NUCEOTIDE/NUCLEOTIDE.github.io/our design.jpg

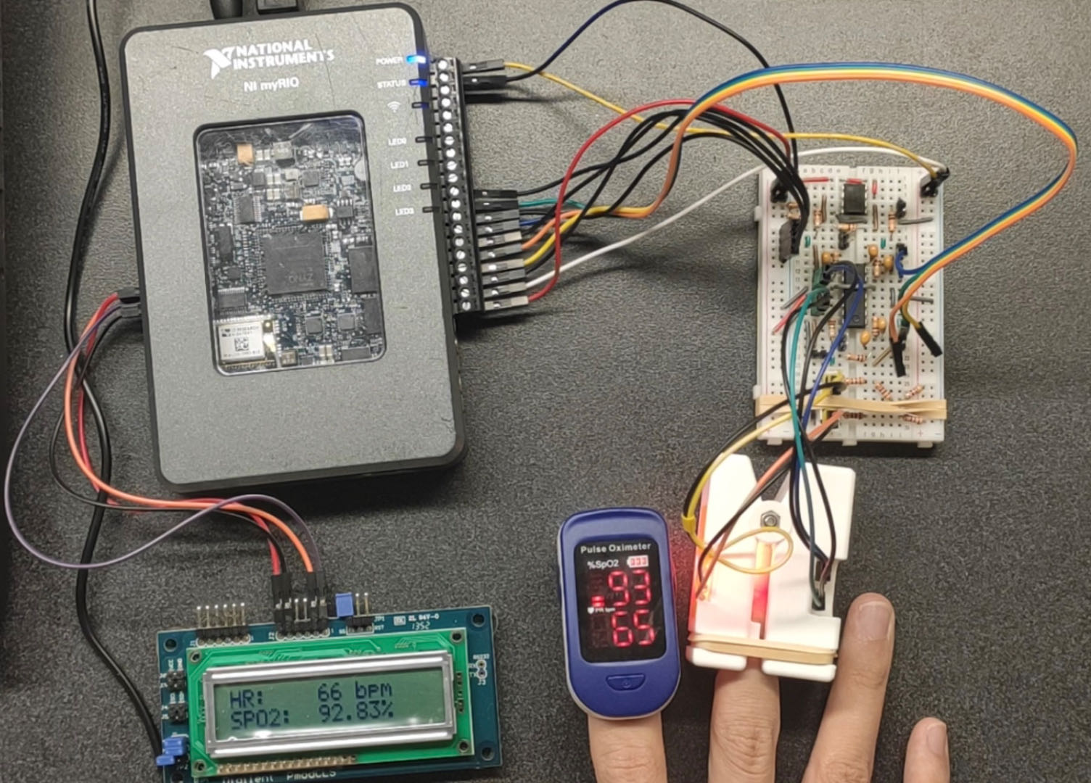
our design.jpg
