NUCEOTIDE/NUCLEOTIDE.github.io/Experimental Data/finger_5_11_25.jpg

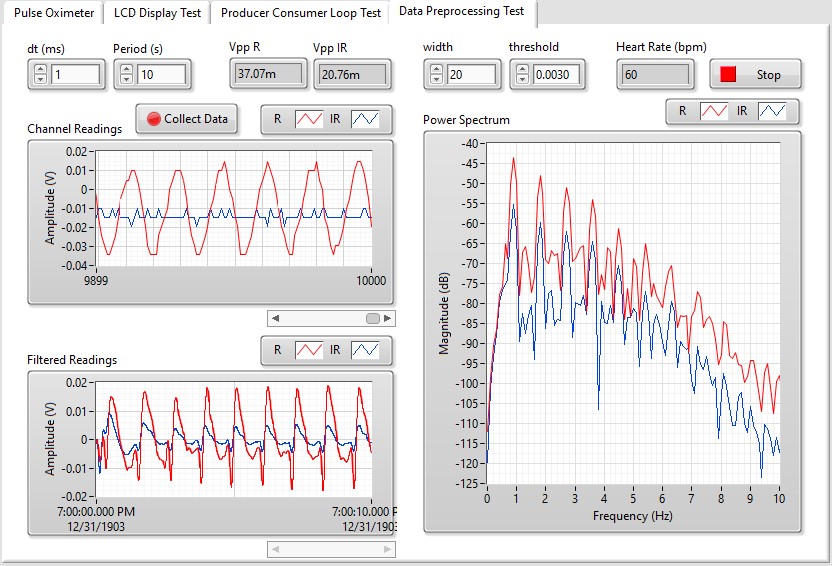
Experimental Data/finger_5_11_25.jpg
