NUCEOTIDE/NUCLEOTIDE.github.io/README.md

# NUCLEOTIDE.github.io
 Github page for ME 6705 FQ2023 Team 8 Pulse Oximeter Demo
