NUCEOTIDE/NUCLEOTIDE.github.io/Design Notes/Final Project SMD v4.pdf

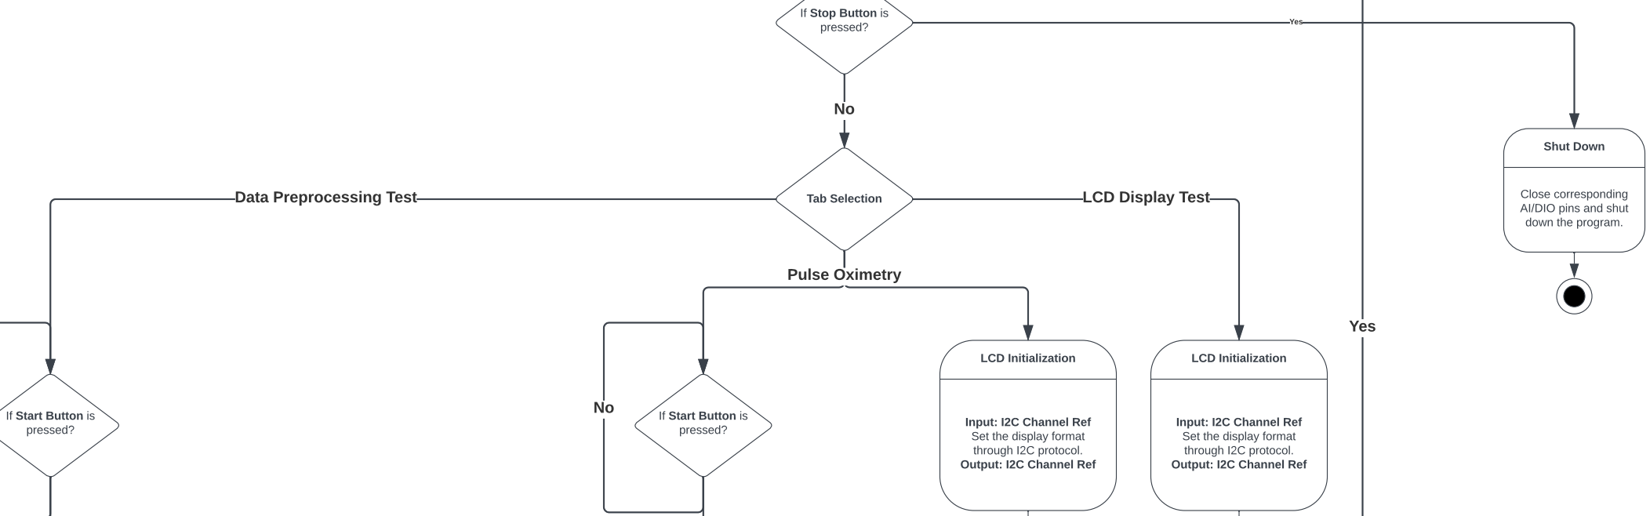
[picture p13: figure]
Shut Down; Close corresponding AI/DIO pins and shut down the program.; Yes; Data Preprocessing Test; Tab Selection; LCD Initialization; Input: I2C Channel Ref Set the display format; If Stop Button is pressed?; LCD Display Test; If Start Button is pressed?; Pulse Oximetry

Retrieve Voltage Readings

Input: AI DIO I2C Channel Ref, Record Params (Interval, Period) Retrieve the amplified/filtered voltage

readings from the R/IR photodiodes and store them in arrays. Output: R and IR channel Voltage Readings

If Time >= Period?

No

Yes

Calculate Blood-oxygen
Saturation and Heartrate

Input: Peak Detection Params (Width, %Threshold), SpO2
Params (R offset, IR offset) From the recorded oscillatory light intensity readings, find the average maximum and minimum intensity. Obtain the blood-oxygen saturation

according to derived formulas. Conduct a frequency analysis and

obtain the heartrate. Output: Light Intensity or

Illuminance (Imax R, Imin R, Imax IR, Imin IR), FFT (Max Freq R, Max Freq IR), SpO2, Heart Rate

Yes

LCD Refresh

Input: I2C Channel Ref, SpO2, Heart Rate Display the calculated

blood-oxygen saturation and heartrate on the LCD screen Output: Displayed Value

Interval ms

LabVIEW Display

Input: Light Intensity or
Illuminance (Imax R, Imin R, Imax IR, Imin IR), FFT (Max Freq R, Max Freq IR), SpO2, Heart Rate Display the obtained values and waveforms in corresponding

display zones.

Initialization

Initialize 2 AI Channels for R and IR photodiodes, 1 DI Channel for button, 2 I2C Channels for LCD Module Output: AI DIO I2C Channel Ref

through I2C protocol. Output: I2C Channel Ref

through I2C protocol. Output: I2C Channel Ref

## Yes

LCD Refresh

Input: I2C Channel Ref, SpO2, Heart Rate Display the calculated

blood-oxygen saturation and heartrate on the LCD screen Output: Displayed Value

If Stop Refreshing Button is

pressed?

No

Retrieve Voltage Readings

Input: AI DIO I2C Channel Ref, Record Params (Interval, Period) Retrieve the amplified/filtered voltage

readings from the R/IR photodiodes and store them in arrays. Output: R and IR channel Voltage Readings

If Time >= Period?

Yes

Yes

## Yes

No

LabVIEW Display

Input: Raw 2 Channel
Photodiode Waveform Signals Display the obtained values and waveforms in corresponding

display zones.

No

Calculate Blood-oxygen
Saturation and Heartrate

Input: Peak Detection Params (Width, %Threshold), SpO2
Params (R offset, IR offset) From the recorded oscillatory light intensity readings, find the average maximum and minimum intensity. Obtain the blood-oxygen saturation

according to derived formulas. Conduct a frequency analysis and

obtain the heartrate. Output: Light Intensity or

Illuminance (Imax R, Imin R, Imax IR, Imin IR), FFT (Max Freq R, Max Freq IR), SpO2, Heart Rate

LabVIEW Display

Input: Light Intensity or
Illuminance (Imax R, Imin R, Imax IR, Imin IR), FFT (Max Freq R, Max Freq IR), SpO2, Heart Rate Display the obtained values and waveforms in corresponding

display zones.

Interval ms
