NUCEOTIDE/NUCLEOTIDE.github.io/3D Design and Modeling/Finger Clip Design 1.png

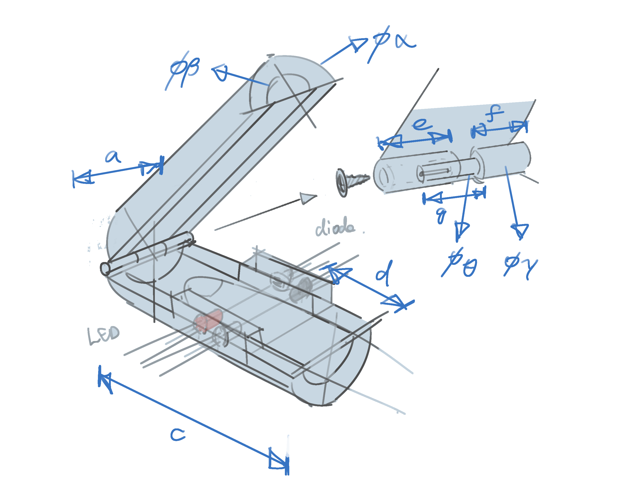
3D Design and Modeling/Finger Clip Design 1.png
