NUCEOTIDE/NUCLEOTIDE.github.io/Circuit Design and Characterization/Lab 7 Conditioning Circuit-schematic.png

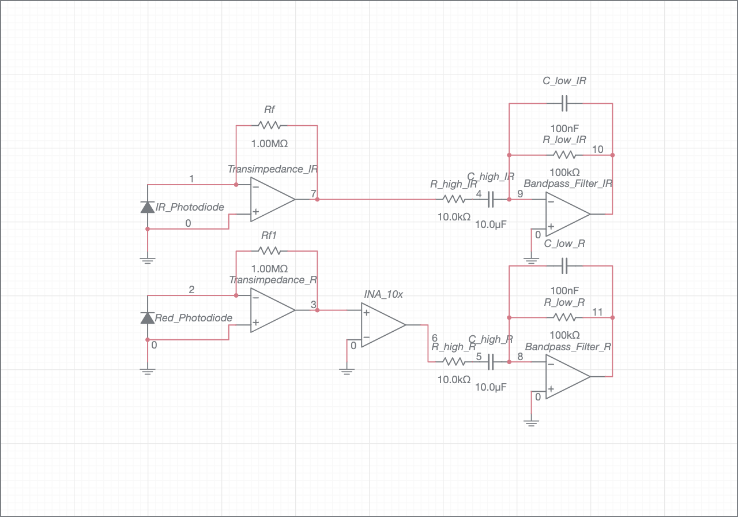
Circuit Design and Characterization/Lab 7 Conditioning Circuit-schematic.png
