NUCEOTIDE/NUCLEOTIDE.github.io/Circuit Design and Characterization/LED schematics v1.jpg

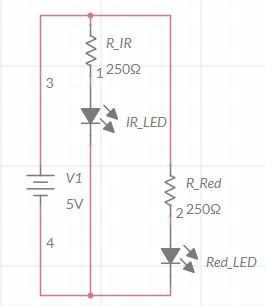
Circuit Design and Characterization/LED schematics v1.jpg
