NUCEOTIDE/NUCLEOTIDE.github.io/Design Notes/Front Panel/Pulse Oximeter Tab.jpg

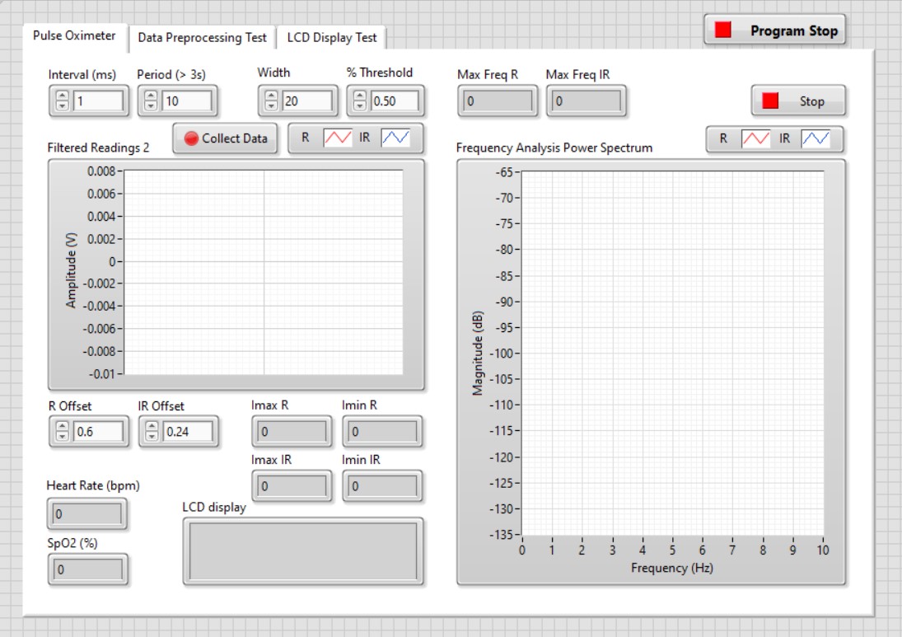
Design Notes/Front Panel/Pulse Oximeter Tab.jpg
