NUCEOTIDE/NUCLEOTIDE.github.io/Design Notes/Sub VIs/Data Acqu.jpg

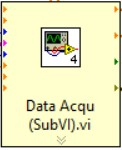
Design Notes/Sub VIs/Data Acqu.jpg
