NUCEOTIDE/NUCLEOTIDE.github.io/Design Notes/Sub VIs/Frequency Analysis.jpg

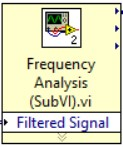
Design Notes/Sub VIs/Frequency Analysis.jpg
