NUCEOTIDE/NUCLEOTIDE.github.io/Design Notes/Sub VIs/Heart Rate.jpg

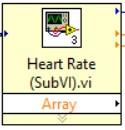
Design Notes/Sub VIs/Heart Rate.jpg
