NUCEOTIDE/NUCLEOTIDE.github.io/Design Notes/Sub VIs/Illuminance.jpg

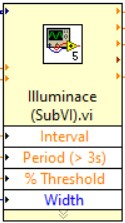
Design Notes/Sub VIs/Illuminance.jpg
