NUCEOTIDE/NUCLEOTIDE.github.io/Design Notes/Sub VIs/SpO2.jpg

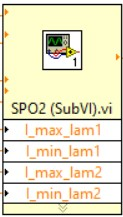
Design Notes/Sub VIs/SpO2.jpg
