NUCEOTIDE/NUCLEOTIDE.github.io/Team8_Canvas_Submission_Final_Project/Engineering and User Specifications Team8_Yifei_Tianyang_v21.xlsx

Sheet: Draft
ME/AE 6705 Final Project Technical Requirements - Template
Detailing engineering and user specifications
Project Title: |  | Digital Pulse Oximiter
Team Number: |  | 8
Team Names: |  | Tianyang Hu, Yifei Du
Category | No. | Threshold/Objective* | Requirement | Value | Unit | Comment
Interface |  | T | Users shall interface with the prototype via a Labview Control Panel | T/F
 |  | O | System will provide debug logs to the Labview Control Panel | T/F
Data Capturing |  | T | System will sample new photodiode data at least every 3 ms (interval < 60Hz power line). | 3 | ms | (sampling with a higher frequency allows higher-quality signal conditioning)
 |  | O | System will sample photodiode data continuously to obtain an moving average heart rate and blood oxygen saturation level. | T/F
 |  | O | System will sample photodiode data under controlled environment (fixed ambient lighting / sealed environment) | T/F
 |  | T | System will sample new photodiode data at least every 6 ms (interval < 60Hz power line). | 6 | ms
Signal Conditioning |  | T | System will transform and amplify the photodiode signal fed into myRio AI ports should be 0 to >80% of channel range (0-5V) | ±50 | mV
 |  | T | System will filter the photodiode signal approately to get rid of sensor noise/drift, bias currents of electrical components, and power-line noise. (at least 2x heart rate < filter passband < powerline noise frquency) | ±5 | Hz | (will need op-amps TLE 2074 or similar, INA 141 or AD620 if necessary, resistors of 10㏀, 100㏀, and 1㏁; capacitors of 10 𝝁F and 100 nF) (Preliminary calculations only)
 |  | T | System will automatically calibrate upon start button press for different patients (different finger thicknesses, skin colors, etc) | T/F |  | (will need a reference to determine the effectiveness and accuracy of the system)
Weight/Dimensions |  | T | Prototype weight (+/-) (not including the breadboard, myRio, or usb cables) | 200 | g
 |  | T | Prototype width (not including the breadboard, myRio, or usb cables) | 3 to 6 | cm
 |  | O | Prototype length (not including the breadboard, myRio, or usb cables) | < 10 | cm
Power & Heat |  | T | Prototype shall operate for 10+ minutes without the need to change batteries | 10 | minute
 |  | T | Prototyoe shall power the LEDs appropriately (given the forward voltage and desired current of the LEDs, determine the appropriate voltage divider and resistors in series) | <10 | mA | (The desired current of IR LED is ~ 50 mA, Red ~ 20 mA; the forward voltage of the IR LED is ~ 1.3V, Red ~ 2.2V)
 |  | T | Prototype LEDs shall not overheat (reach temperature > 40℃) in 5 minutes of continuous operation | 5 | minute
 |  | O | Prototype shall operate for 4 hours without the need to change batteries | 4+ | hour
Quality Control (mandatory) |  | T | Number of system bugs detected upon prototype demonstration | < 5 | bugs
 |  | O | Number of system bugs detected upon prototype demonstration | 0 | bugs
 |  | T | Project professionalism (are wires hanging out? duct tape used? Electrical tape on wires vs. heat-shrink? etc.) | Scale: 1-10 |  | (10 being most professional)
Project requirements (mandatory) |  | T | Prototype uses LabVIEW | T/F
 |  | T | Prototype uses the myRIO | T/F
 |  | T | Prototype uses 2+ actors | T/F |  | 1 Pmod CLS LCD Display, 1 Start Button, 2 LEDs (1 Red 660 nm, 1 IR 940 nm)
 |  | O | Prototype uses at minimum 2 actors to perform meaningful, complex system interactions (i.e. not just using an actor based of a single, simple, sensor data). An example: basic interaction is a single LED indicating prototype is ON/OFF, vs. meaningful interaction is an RGB LED using color to indicate temperature of coffee using a thermocouple. | T/F |  | The prototype will obtain heart rate and blood oxygen level over a period of time (5-10s) after a button press, and display them on the LCD display.
 |  | T | Prototype uses 2+ sensors | T/F |  | 2 photodiodes (1 red, 1 infrared)
 |  | O | Prototype uses at minimum 2 sensors of sufficient complexity. For example: a simple sensor would be a photodiode (boolean ON/OFF), and a complex sensor would be an accelerometer (non-boolean data). | T/F |  | The photodiodes will measure quantitative attenuation of the lights of 2 wavelength as patient's heart beats. Each heart beat brings pulsatile arterial blood into the finger and attenuate lights more. The attenuation differences are then used to obtain the blood oxygen level.
 |  | T | Prototype design/assembly is unique (i.e. not found from a brief Google search) | T/F
 |  | O | Prototype creativity/uniqueness, as determined by customer (Dr. Noel) | Scale: 1-10 |  | (10 being most creative/unique)
 |  | T | Prototype uses at least 1 advanced mechatronics concept | T/F
 |  | O | Prototype goes above and beyond with exploring advanced mechatronics concept | T/F |  | Bonus 5 points to overall project
*Threshold is a mandatory requirement. Objective is a "nice to have" requirement, but not mandatory for success of the project.

Sheet: Final
ME/AE 6705 Final Project Technical Requirements - Template
Detailing engineering and user specifications
Project Title: |  | Digital Pulse Oximiter
Team Number: |  | 8
Team Names: |  | Tianyang Hu, Yifei Du
Category | No. | Threshold/Objective* | Requirement | Value | Unit | Comment
Interface |  | T | Users shall interface with the prototype via a Labview Control Panel | T/F
 |  | O | System will provide debug logs to the Labview Control Panel | T/F
Data Capturing |  | T | System will sample new photodiode data at least every 3 ms (interval < 60Hz power line). | 3 | ms | (sampling with a higher frequency allows higher-quality signal conditioning) (Actual performance, 1 ms - x00 ms with a timed while loop)
 |  | O | System will sample photodiode data continuously to obtain an moving average heart rate and blood oxygen saturation level. | T/F
 |  | O | System will sample photodiode data under controlled environment (fixed ambient lighting / sealed environment) | T/F
Signal Conditioning |  | T | System will transform and amplify the photodiode signal fed into myRio AI ports should be 0 to >80% of channel range (± 10V) | ±50 | mV | System has large offset but small peak-peak amplitudes
 |  | T | System will filter the photodiode signal approately to get rid of sensor noise/drift, bias currents of electrical components, and power-line noise. (at least 0.8x heart rate (Hz) < filter passband < powerline noise frquency) | ±5 | Hz | (will need op-amps TLE 2074 or similar, INA 141 or AD620 if necessary, resistors of 10㏀, 100㏀, and 1㏁; capacitors of 10 𝝁F and 100 nF) (Preliminary calculations only) (Actual system uses LM324 and UA741 with worse performance. Circuit characterized cutoff frequencies at around 2 - 10 Hz)
 |  | T | System will automatically calibrate upon start button press for different patients (different finger thicknesses, skin colors, etc) | T/F |  | (will need a reference to determine the effectiveness and accuracy of the system)
Weight/Dimensions |  | T | Prototype weight (+/-) (not including the breadboard, myRio, or usb cables) | 200 | g
 |  | T | Prototype width (not including the breadboard, myRio, or usb cables) | 3 to 6 | cm
 |  | O | Prototype length (not including the breadboard, myRio, or usb cables) | < 10 | cm
Power & Heat |  | T | Prototype shall operate for 10+ minutes | 10 | minute | (The system ended up using myRio power, and myRio uses wall power)
 |  | T | Prototyoe shall power the LEDs appropriately (given the forward voltage and desired current of the LEDs, determine the appropriate voltage divider and resistors in series) | <10 | mA | (The desired current of IR LED is ~ 50 mA, Red ~ 20 mA; the forward voltage of the IR LED is ~ 1.3V, Red ~ 2.2V)
 |  | T | Prototype LEDs shall not overheat (reach temperature > 40℃) in 5 minutes of continuous operation | 5 | minute
Quality Control (mandatory) |  | T | Number of system bugs detected upon prototype demonstration | < 5 | bugs
 |  | O | Number of system bugs detected upon prototype demonstration | 0 | bugs
 |  | T | Project professionalism (are wires hanging out? duct tape used? Electrical tape on wires vs. heat-shrink? etc.) | Scale: 1-10 |  | (10 being most professional)
Project requirements (mandatory) |  | T | Prototype uses LabVIEW | T/F
 |  | T | Prototype uses the myRIO | T/F
 |  | T | Prototype uses 2+ actors | T/F |  | 1 Pmod CLS LCD Display, 1 Start Button, 2 LEDs (1 Red 660 nm, 1 IR 940 nm)
 |  | O | Prototype uses at minimum 2 actors to perform meaningful, complex system interactions (i.e. not just using an actor based of a single, simple, sensor data). An example: basic interaction is a single LED indicating prototype is ON/OFF, vs. meaningful interaction is an RGB LED using color to indicate temperature of coffee using a thermocouple. | T/F |  | The prototype will obtain heart rate and blood oxygen level over a period of time (5-10s) after a button press, and display them on the LCD display.
 |  | T | Prototype uses 2+ sensors | T/F |  | 2 photodiodes (1 red, 1 infrared)
 |  | O | Prototype uses at minimum 2 sensors of sufficient complexity. For example: a simple sensor would be a photodiode (boolean ON/OFF), and a complex sensor would be an accelerometer (non-boolean data). | T/F |  | The photodiodes will measure quantitative attenuation of the lights of 2 wavelength as patient's heart beats. Each heart beat brings pulsatile arterial blood into the finger and attenuate lights more. The attenuation differences are then used to obtain the blood oxygen level.
 |  | T | Prototype design/assembly is unique (i.e. not found from a brief Google search) | T/F
 |  | O | Prototype creativity/uniqueness, as determined by customer (Dr. Noel) | Scale: 1-10 |  | (10 being most creative/unique)
 |  | T | Prototype uses at least 1 advanced mechatronics concept | T/F
 |  | O | Prototype goes above and beyond with exploring advanced mechatronics concept | T/F |  | Bonus 5 points to overall project
*Threshold is a mandatory requirement. Objective is a "nice to have" requirement, but not mandatory for success of the project.
