NUCEOTIDE/NUCLEOTIDE.github.io/Engineering Specifications/Engineering and User Specifications Template.xlsx

ME/AE 6705 Final Project Technical Requirements - Template
Detailing engineering and user specifications
Project Title:
Team Number:
Team Names:
[Remove this text before submission] I have provided some examples of category options and requirements below. You will need to add/delete categories/requirements as needed for your specific project. The project requirements category and quality control category (and associated requirements lists) are mandatory and should not be deleted.
[Remove this text before submission] Note: not all categories may be relevant to your project! For example, weight/dimensions may not matter for a garden monitor prototype, but will matter significantly for a high-altitude balloon prototype.
Category | No. | Threshold/Objective* | Requirement | Value | Unit | Comment
Interface | 1 | T | Users shall interface with the prototype via a web interface | T/F
 | 2 | O | System will provide debug logs to the web interface | T/F
Data Capturing | 3 | T | System will read new accelerometer data every 1 ms. | 1 | ms
Control | 4 | T | System will reach a steady state PID response within threshold | 0.5 | s
 | 5 | T | System will be responsive to added load (+/- load) | 10 | lbs
Weight/Dimensions | 6 | T | Prototype weight (+/-) | 5 | lbs
 | 7 | T | Prototype width | 3 to 6 | inch
 | 8 | O | Prototype width | < 4 | inch
Power | 9 | T | Prototype shall operate for 1 hour without the need to change batteries | 1 | hour
 | 10 | O | Prototype shall operate for 4 hours without the need to change batteries | 4+ | hour
Quality Control (mandatory) | 11 | T | Number of system bugs detected upon prototype demonstration | < 5 | bugs
 | 12 | O | Number of system bugs detected upon prototype demonstration | 0 | bugs
 | 13 | T | Project professionalism (are wires hanging out? duct tape used? Electrical tape on wires vs. heat-shrink? etc.) | Scale: 1-10 |  | (10 being most professional)
Project requirements (mandatory) | 14 | T | Prototype uses LabVIEW | T/F
 | 15 | T | Prototype uses the myRIO | T/F
 | 16 | T | Prototype uses 2+ actors | T/F
 | 17 | O | Prototype uses at minimum 2 actors to perform meaningful, complex system interactions (i.e. not just using an actor based of a single, simple, sensor data). An example: basic interaction is a single LED indicating prototype is ON/OFF, vs. meaningful interaction is an RGB LED using color to indicate temperature of coffee using a thermocouple. | T/F
 | 18 | T | Prototype uses 2+ sensors | T/F
 | 19 | O | Prototype uses at minimum 2 sensors of sufficient complexity. For example: a simple sensor would be a photodiode (boolean ON/OFF), and a complex sensor would be an accelerometer (non-boolean data). | T/F
 | 20 | T | Prototype design/assembly is unique (i.e. not found from a brief Google search) | T/F
 | 21 | O | Prototype creativity/uniqueness, as determined by customer (Dr. Noel) | Scale: 1-10 |  | (10 being most creative/unique)
 | 22 | T | Prototype uses at least 1 advanced mechatronics concept | T/F
 | 23 | O | Prototype goes above and beyond with exploring advanced mechatronics concept | T/F |  | Bonus 5 points to overall project
*Threshold is a mandatory requirement. Objective is a "nice to have" requirement, but not mandatory for success of the project.
