NUCEOTIDE/NUCLEOTIDE.github.io/3D Design and Modeling/3D Printing/Pulse Oximeter v2 v2 bottom.stl

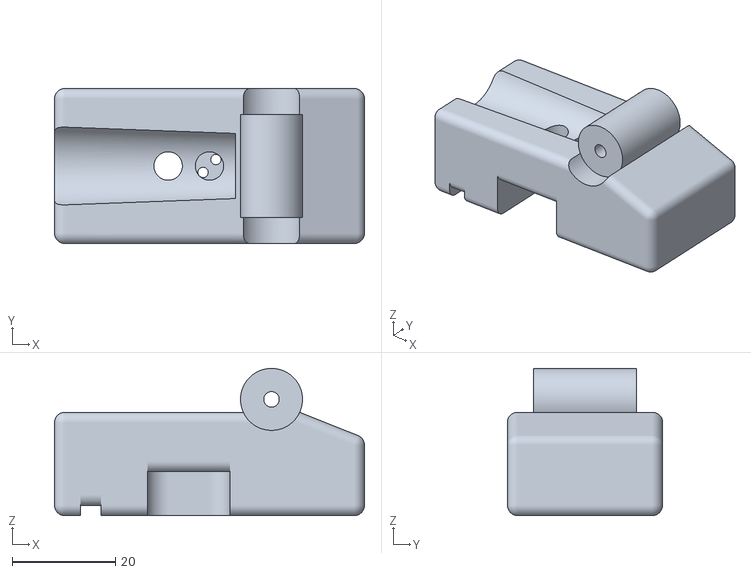
[picture p23: CAD file, 2023-11-29]
3D Design and Modeling/3D Printing/Pulse Oximeter v2 v2 bottom.stl
60.0 x 30.0 x 28.5
