NUCEOTIDE/NUCLEOTIDE.github.io/3D Design and Modeling/3D Printing/Pulse Oximeter v2 v1 top.stl

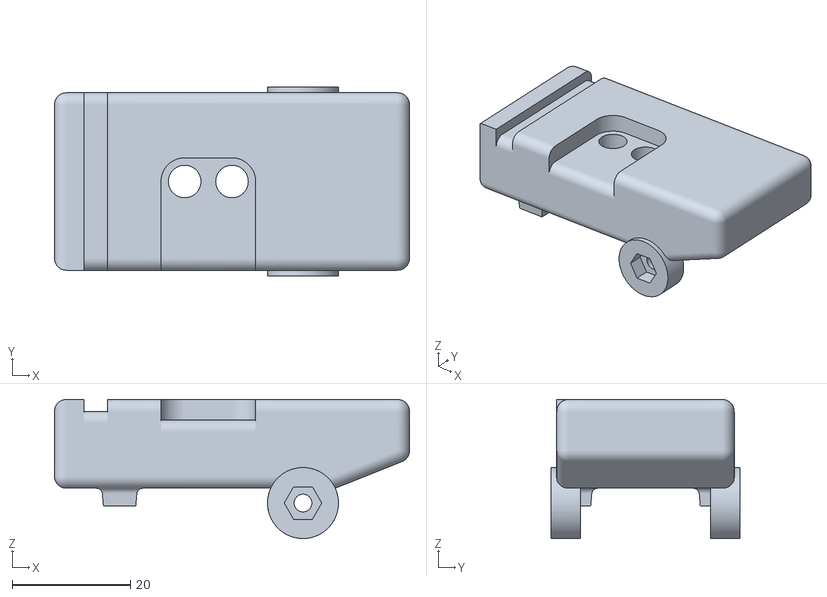
[picture p24: CAD file, 2023-11-29]
3D Design and Modeling/3D Printing/Pulse Oximeter v2 v1 top.stl
60.0 x 32.0 x 23.5
