NUCEOTIDE/NUCLEOTIDE.github.io/3D Design and Modeling/3D Printing/Pulse Oximeter v1 v3.stl

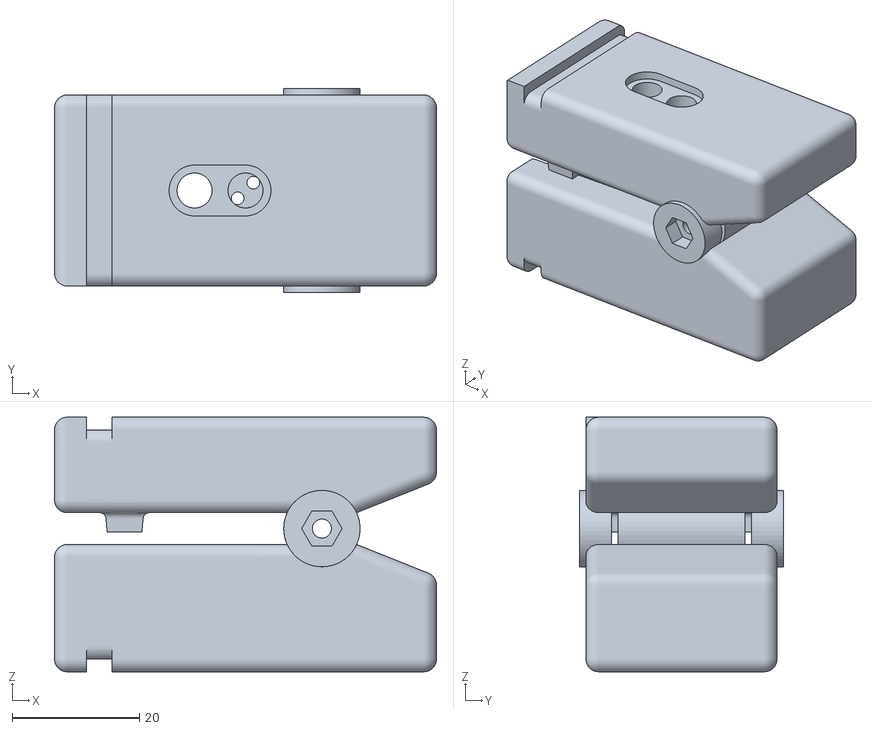
[picture p26: CAD file, 2023-11-29]
3D Design and Modeling/3D Printing/Pulse Oximeter v1 v3.stl
60.0 x 32.0 x 40.0
