NUCEOTIDE/NUCLEOTIDE.github.io/(list of files, cad)

Other CAD files:
3D Design and Modeling/3D Printing/Pulse Oximeter v1 v3 bottom.stl
3D Design and Modeling/Pulse Oximeter v1 v4.f3d
