NUCEOTIDE/NUCLEOTIDE.github.io/Circuit Design and Characterization/Active Filter Circuit Characterization - Frequency Response Magnitude.xlsx

R
Frequency (Hz) | Input (Vpp) | Output (Vpp) | Gain | Gain (dB)
0.2 | 0.034 | 0.336 | 9.882352941 | 19.89720721
0.5 | 0.043 | 0.439 | 10.20930233 | 20.17992129
1 | 0.039 | 0.996 | 25.53846154 | 28.14389463
2 | 0.039 | 1.436 | 36.82051282 | 31.32179666
5 | 0.039 | 1.799 | 46.12820513 | 33.27933113
10 | 0.039 | 1.548 | 39.69230769 | 31.97412699
20 | 0.039 | 1.167 | 29.92307692 | 29.52012498
50 | 0.044 | 0.571 | 12.97727273 | 22.26366864
100 | 0.039 | 0.312 | 8 | 18.06179974
200 | 0.039 | 0.166 | 4.256410256 | 12.58086962
IR
Frequency (Hz) | Input (Vpp) | Output (Vpp) | Gain | Gain (dB)
0.2 | 0.039 | 0.048 | 1.230769231 | 1.803532607
0.5 | 0.039 | 0.054 | 1.384615385 | 2.826583056
1 | 0.034 | 0.112 | 3.294117647 | 10.35478211
2 | 0.034 | 0.161 | 4.735294118 | 13.50693918
5 | 0.039 | 0.19 | 4.871794872 | 13.75377988
10 | 0.039 | 0.175 | 4.487179487 | 13.03946883
20 | 0.039 | 0.141 | 3.615384615 | 11.16309011
50 | 0.039 | 0.078 | 2 | 6.020599913
100 | 0.039 | 0.052 | 1.333333333 | 2.498774732
200 | 0.039 | 0.034 | 0.8717948718 | -1.1917138
