NUCEOTIDE/NUCLEOTIDE.github.io/Circuit Design and Characterization/LM324 Pin Config.jpg

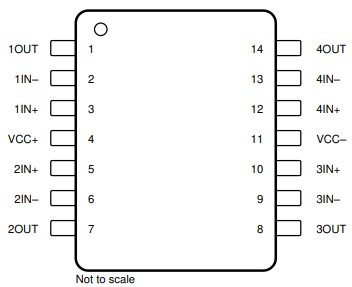
Circuit Design and Characterization/LM324 Pin Config.jpg
