NUCEOTIDE/NUCLEOTIDE.github.io/Circuit Design and Characterization/LM386 Pin Config.jpg

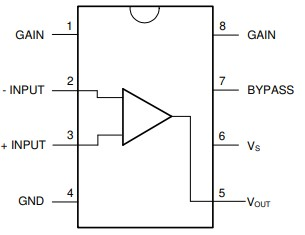
Circuit Design and Characterization/LM386 Pin Config.jpg
