NUCEOTIDE/NUCLEOTIDE.github.io/Design Notes/Front Panel/Data Preprocessing Test Tab.jpg

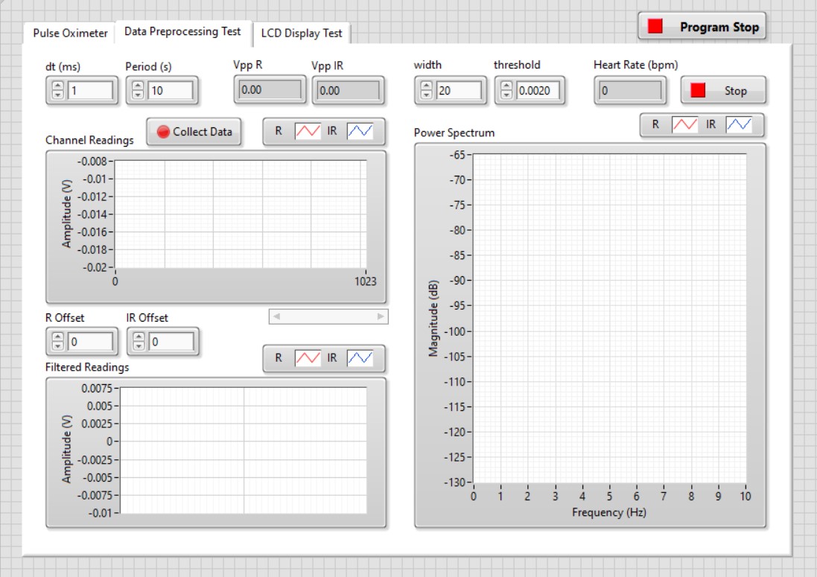
Design Notes/Front Panel/Data Preprocessing Test Tab.jpg
