NUCEOTIDE/NUCLEOTIDE.github.io/Design Notes/Front Panel/LCD Display Test Tab.jpg

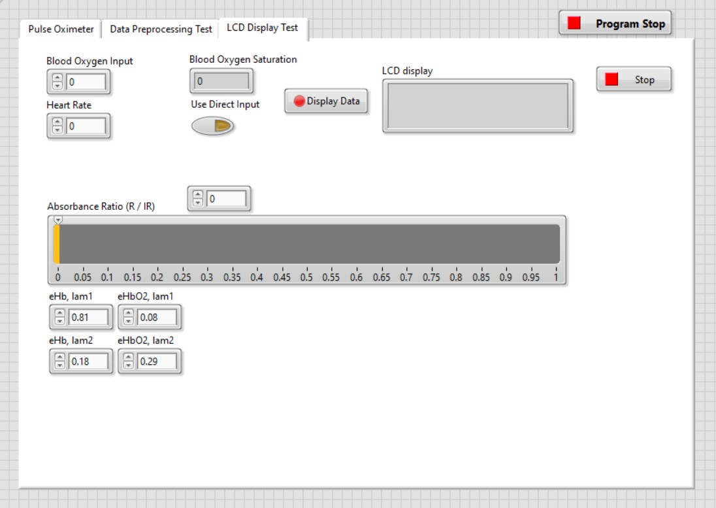
Design Notes/Front Panel/LCD Display Test Tab.jpg
