NUCEOTIDE/NUCLEOTIDE.github.io/Experimental Data/finger_5_11_25_4.jpg

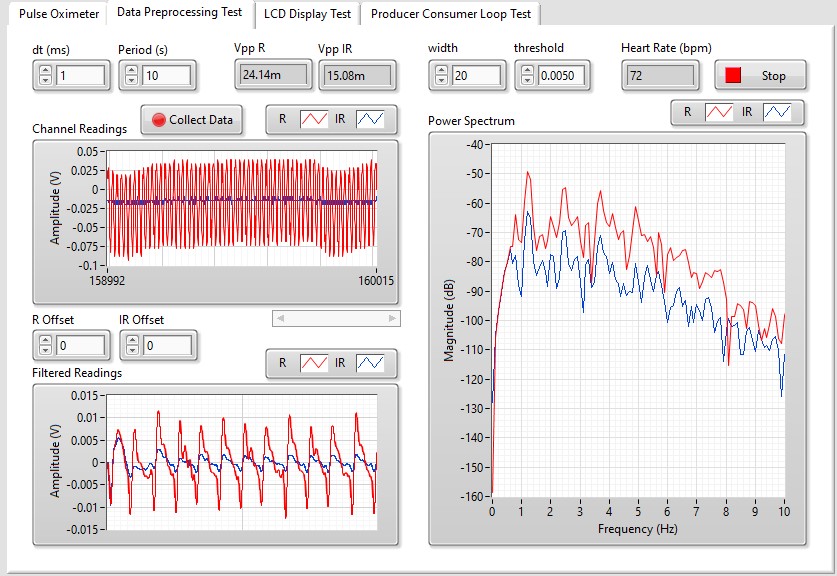
Experimental Data/finger_5_11_25_4.jpg
