NUCEOTIDE/NUCLEOTIDE.github.io/Experimental Data/finger_6_11_27_1.jpg

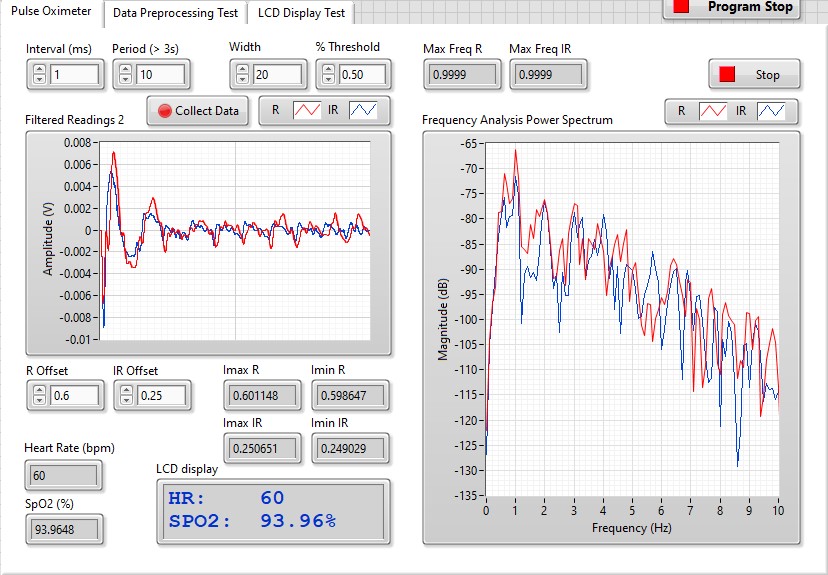
Experimental Data/finger_6_11_27_1.jpg
