NUCEOTIDE/NUCLEOTIDE.github.io/Experimental Data/waveform data.jpg

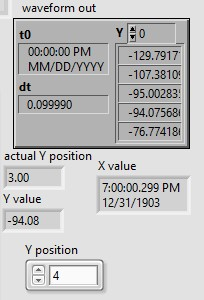
Experimental Data/waveform data.jpg
