NUCEOTIDE/NUCLEOTIDE.github.io/Experimental Data/waveform graph data.jpg

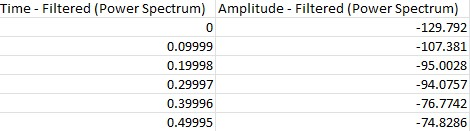
Experimental Data/waveform graph data.jpg
