NUCEOTIDE/NUCLEOTIDE.github.io/Design Notes/Final Project Design Notes.pdf

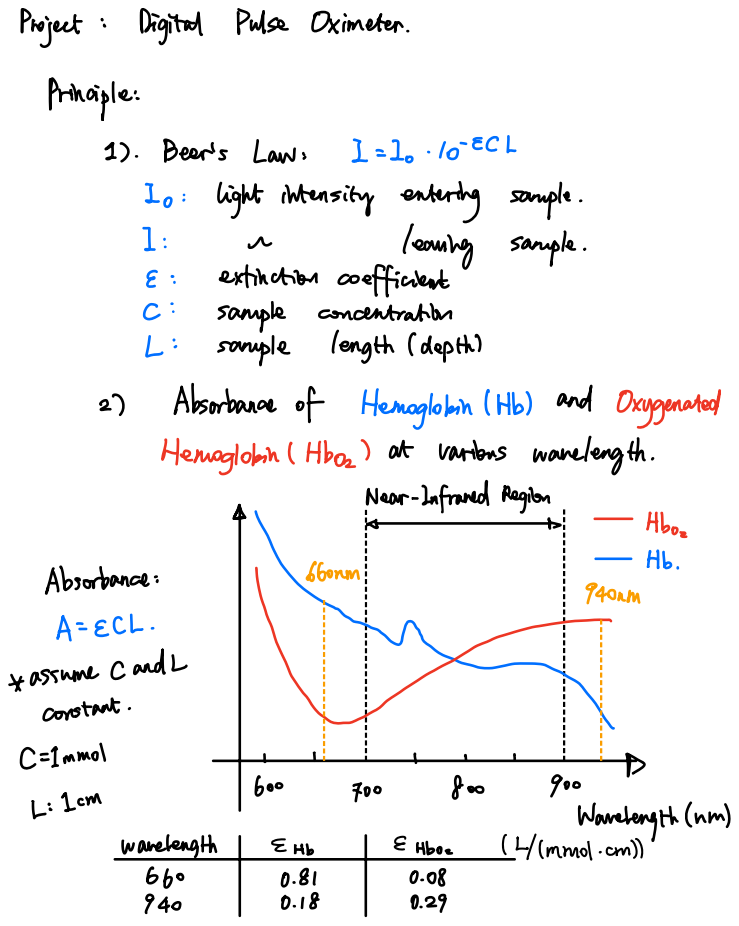
[picture p37: page 1]
Project; Digital Pulse Oximeter; Beer's Law; 2 20 to ECL; leaving sample; extinction coefficient; sample concentration; sample length depth; Absorbance of Hemoglobin Hb and Oxygenated; Absorbance; A ECL assumecandle; constant; C mmol; Goo; gem; too; Wavelength nml; wangen9th; Egg; Embo; 141mmolcmll

Principle
Io light intensity entering sample

Hemoglobin Hbo at various wavelength
NearInfraredRegion A

by

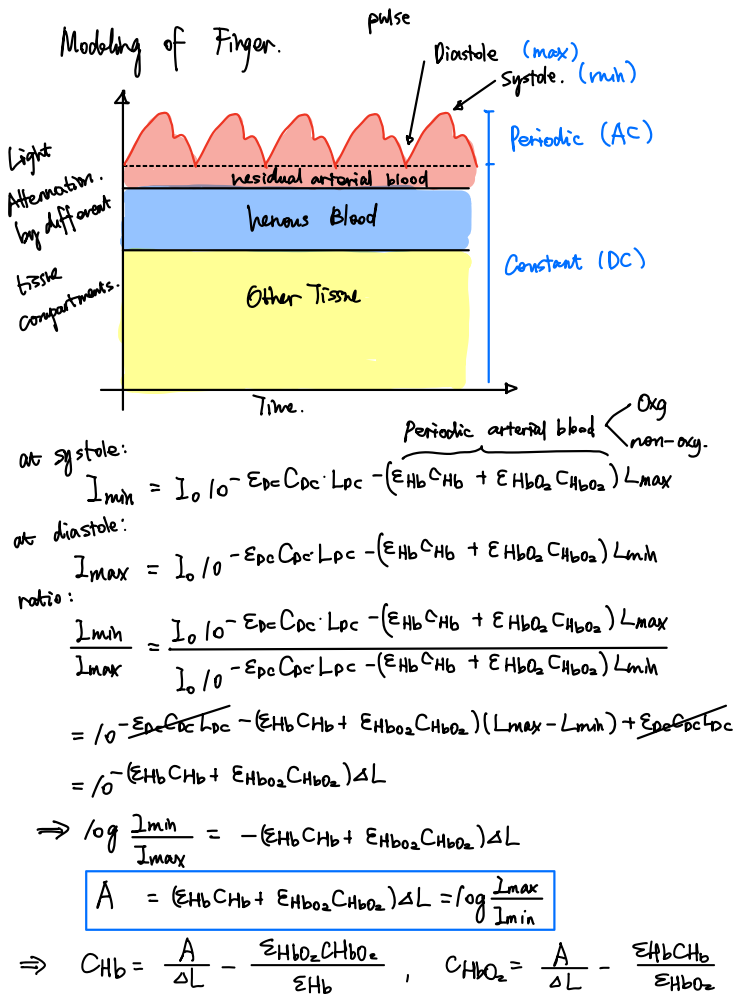
[picture p38: page 2]
pase; Diastole system min; light Hematin; MMA; Periodic Act; residualarterial blood; different; henous Blood; Constant IDC; Effgartments; OtherTissue; non oxy; log mmmm; EHbCHbt Emboachboa DL; HbCHbt Emboachbo OL og; Imax 2min; Hbcu Cab; I EHbachbo; Cabo; EHb; EHboz

Modeling of Finger

Time
1min Lolo encore pettifogging
at systole

at diastole
Imax 2 o EpcCpaLps Hb Hb t EHbozchboatLain
ratio
to¹⁰ EDCDCLPs CEHb Hb t EHbosCabo I Lmax 2min

2 p EpcCpaLps EHb Hb EHbosCHboatLenin

o EpCDsLps HbCHbt EmboachboatILmax Lms Epaspits

6 HbCHbt Emboachboz DL

## Ada EmbxzCHb t Ehboz if Hbo lol

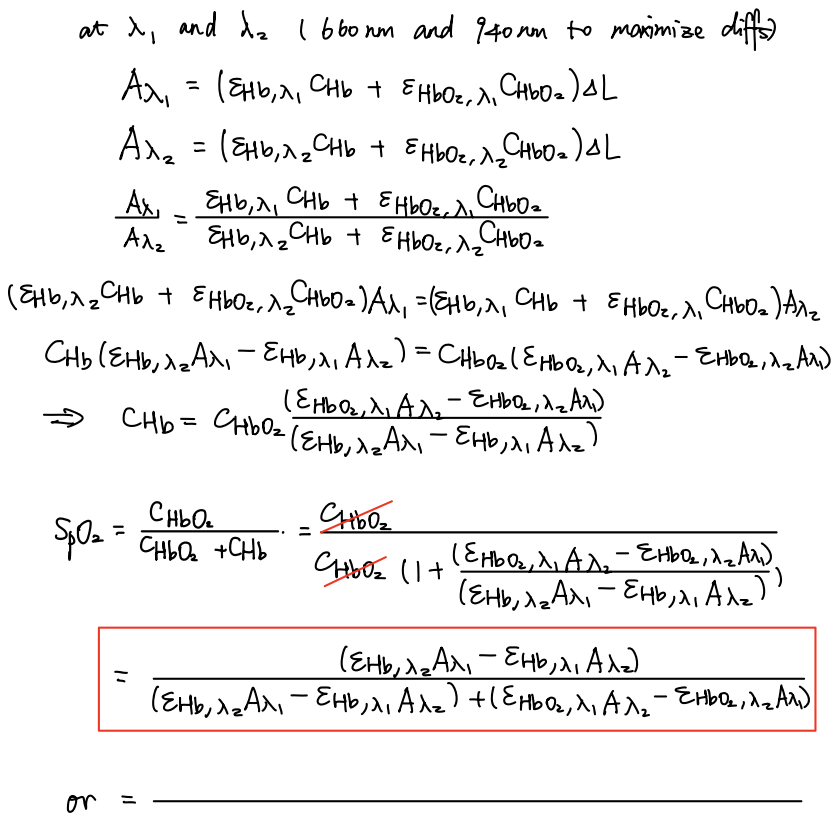
[picture p39: page 3]
at X and I; I 66ohm and 940am to maximize diffs; Erb x Chb t EHboz NCHboa DL; Anz EmbxzCHb t EHboz; Hbos; spa 41 4

Ah Emb x Chb t EHbozNCHbos

RnbxzCHb t Ehboz if Hbos Ai Emb x Chb t EHboz NCHbos iz

Chb EmbAzan Embed All CHboz Erebor x Ax Embark Ah
IEmboz x Ax Emba Yeah Chb Chbozieubazan Embed Aid

Chiba
Chboz it Erba N Ax Emba team

KmbxzAn Embed And I

lEHbxzAn Embed And

EmbAzan EmbedAnd t Erebor n Ans Embark Ah

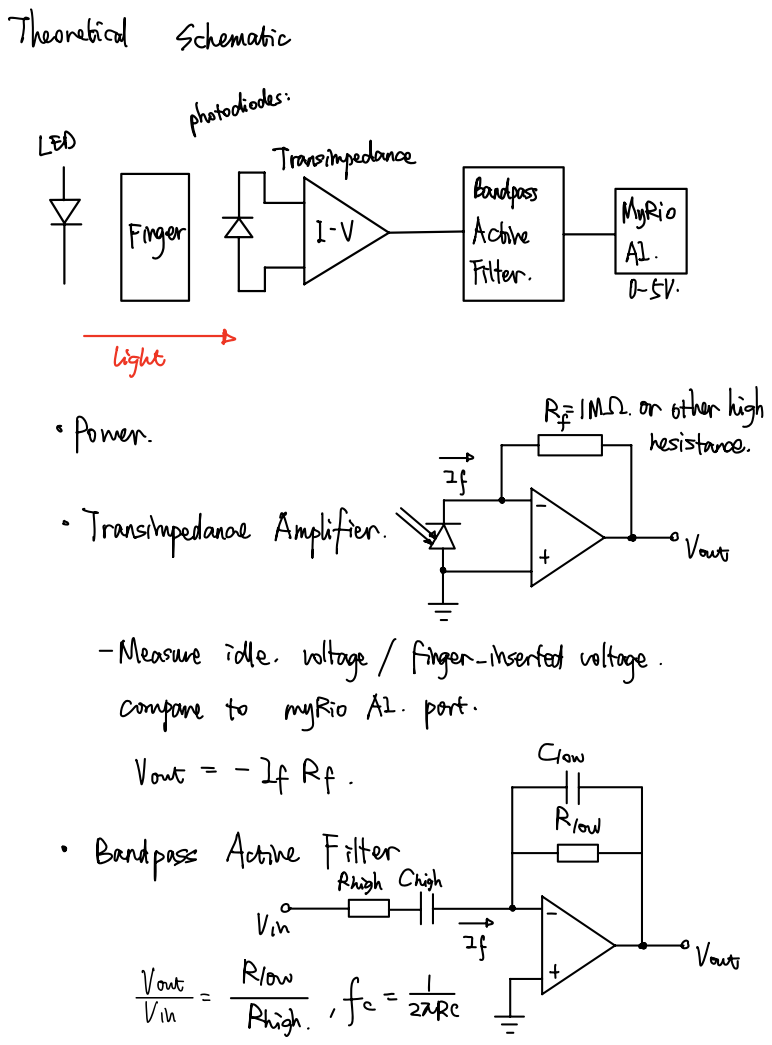
[picture p40: page 4]
Theoretical; Schematic; photodiodes; LED; Transimpedance; Bandpass; Myrie; Finger; Active; Filter; Esv; light; Power; resistance; Transimpedance Amplifier; Vout; Measure idle voltage; finger inserted voltage; Clow Vout; Row; Yount

REIMS or otherhigh

compare to myRio AL port

Bandpass Active Tpittycnish

Row
Rhigh if tape

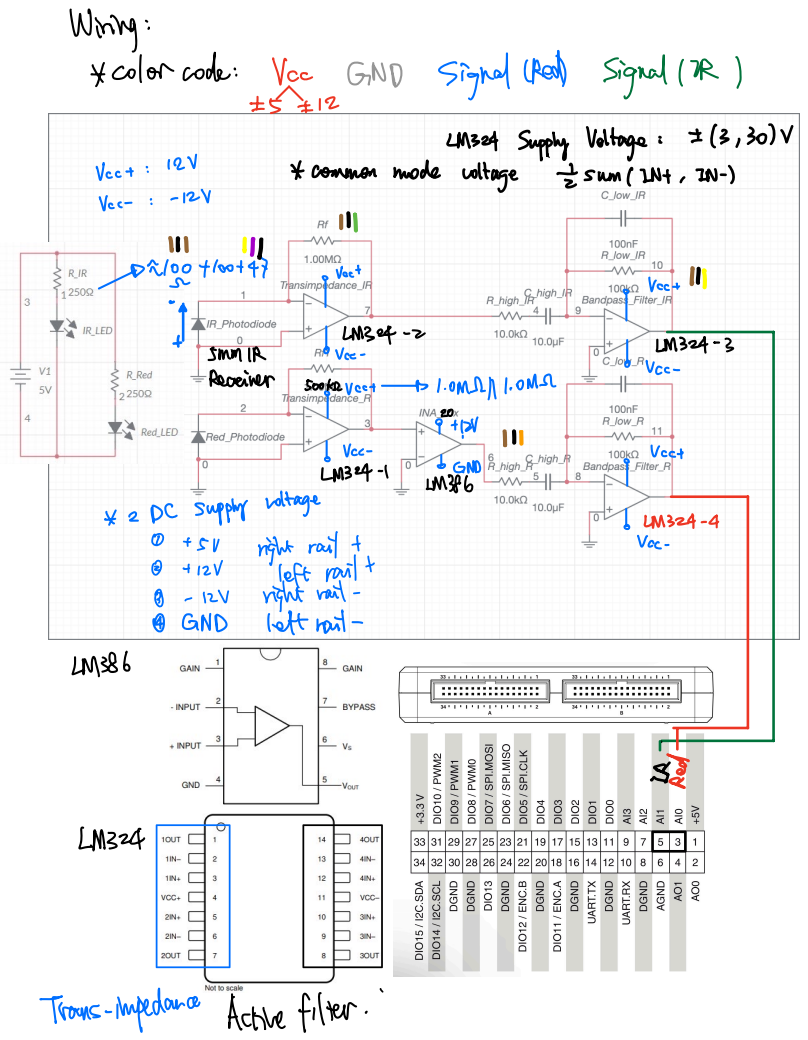
[picture p41: page 5]
LM324 Supply Voltage; common mode cottage; Esumeant an 1; paidthot; vast; Vast'll; I jump; lil; init 1 anggun; ftp³²⁴ ⁴; IIE; GND lefttail; LM³⁸⁶

Wiring
colorcode Va GND Signal Red Signal R

Receiver soqkrviatbl.omrpt.am

ape supply wage

Trans impedance Activefilter

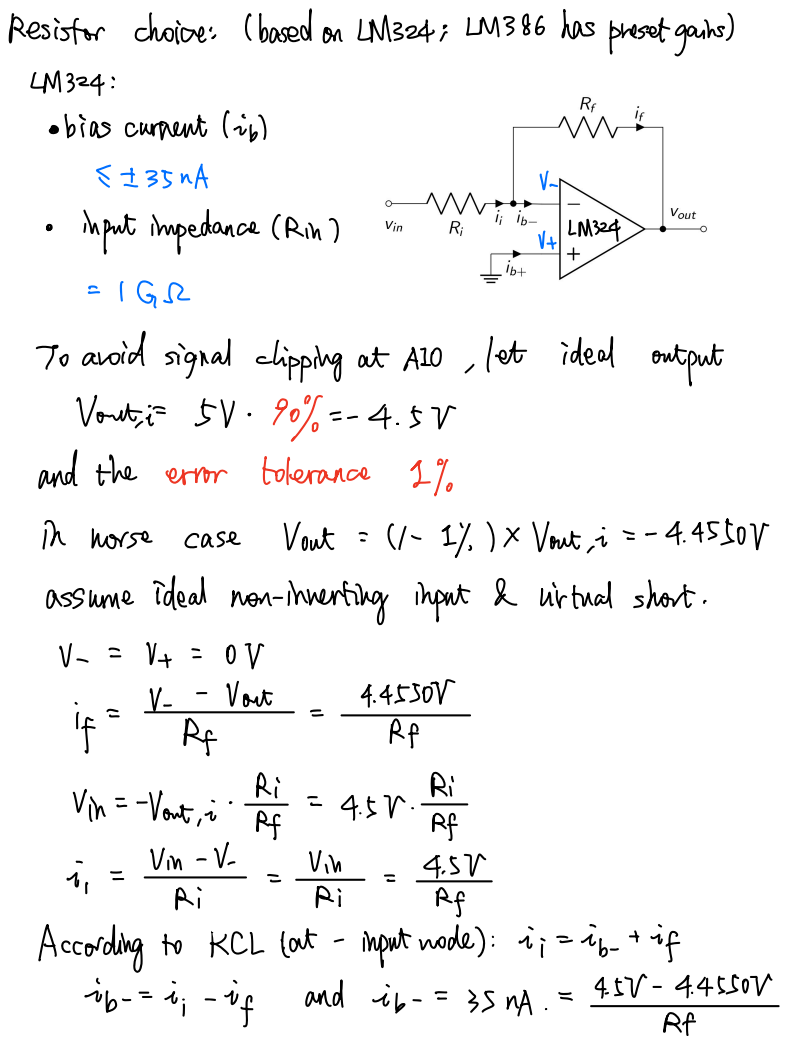
[picture p42: page 6]
inputimpedance IRin; Th horse case; Vout; 11 11 I x Vout i; assume ideal non inverting input; virtual short; Voit; Vin Vout i Rpf; According to KCL hat inputnode i i; if and i b

Resistor choice Ibasedon LM324 LM386haspresetgains
bias current tip
To avoid signal clipping at Alo let ideal output
Vote JV 901 4.5 V
and the error tolerance 2

1 3 1062 13my

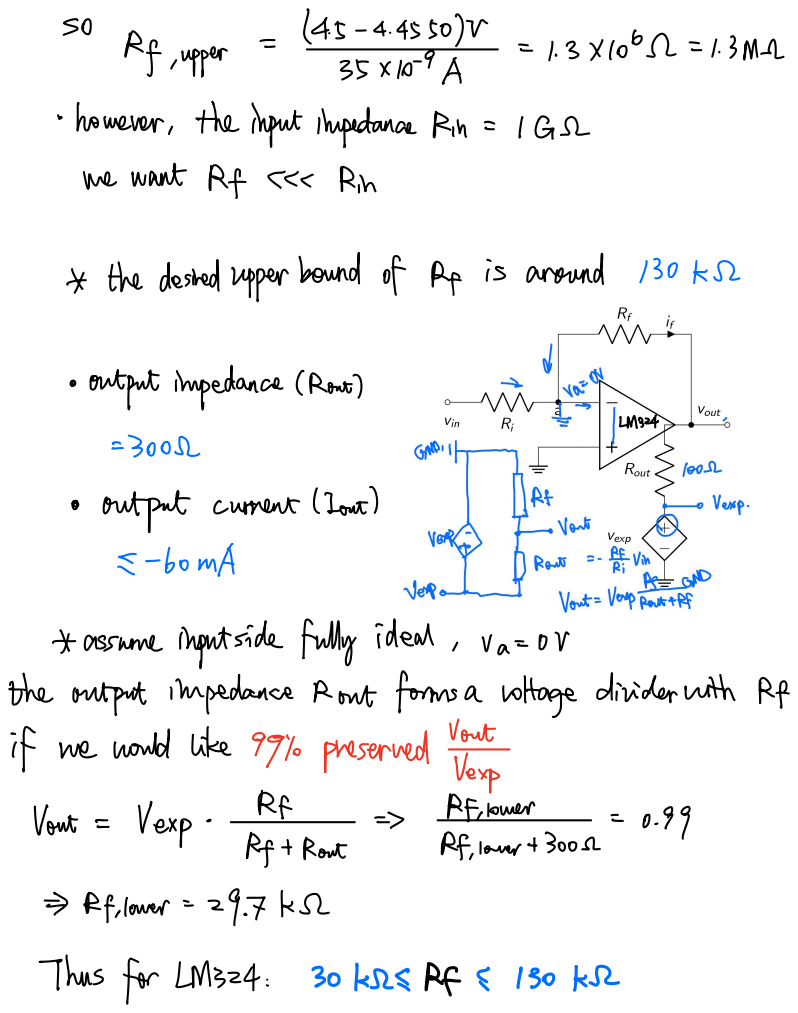
[picture p43: page 7]
Rf upper; however theinputimpedanceRin; the desiredupper; out; Vexp Rf Vont; Vexp Ry por; RFlower Rflower 3002

me want Rf Ke Rin

bound of Rf is around 130 Kr

output impedance IRout

output current 1Loud
assume inputside fully ideal va or
the output impedance Rout forms a cottage dividerwith Rf
if we would like 99 preserved

Rflower 29.7 Kr
Thus for LM324 30 Krs Rf E 130 Kr

### Entrypoint

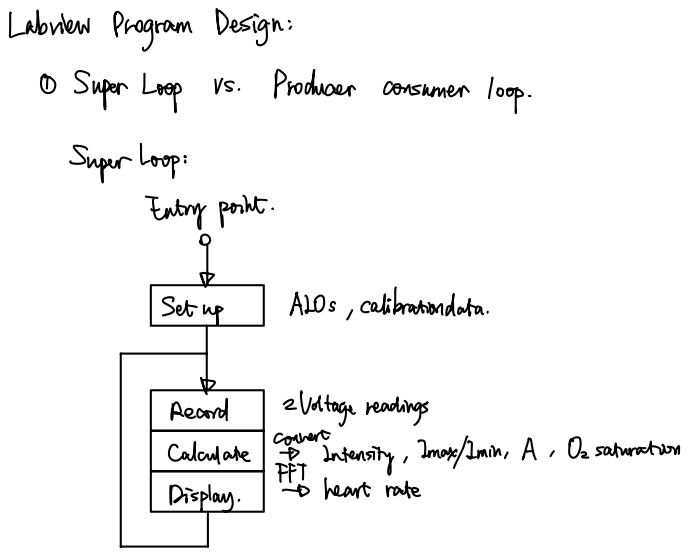
[picture p44: page 8]
SuperLoop; Setup; ALOs calibrationdata; Record; 2Voltagereadings; Display; If heart rate

Labriew Program Design

SuperLoop vs Producer consumer loop

Calculate Thrgentensity Imax2min A Ozsaturation
