NUCEOTIDE/NUCLEOTIDE.github.io/Circuit Design and Characterization/Transimpedance Circuit - Dual or Single Supply.pdf

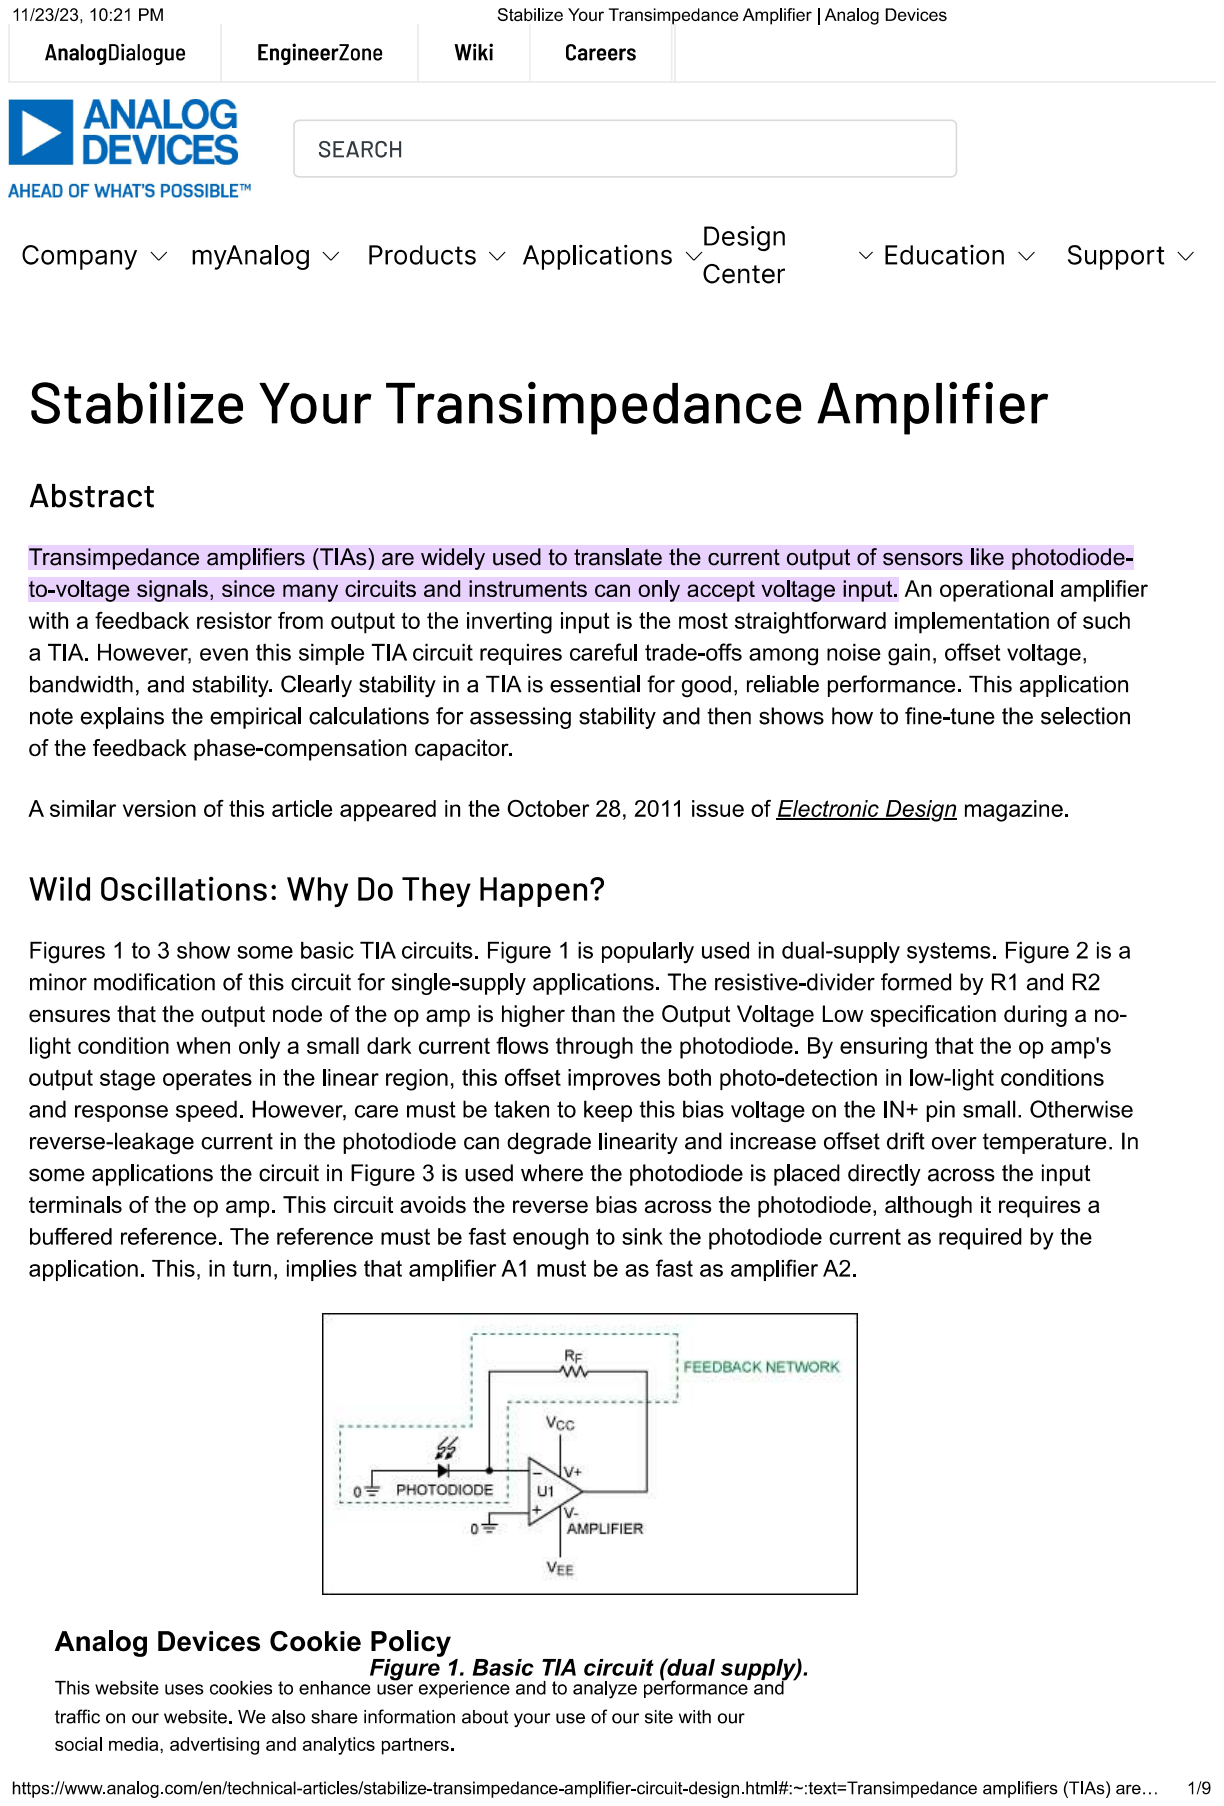
[picture p45: page 1]

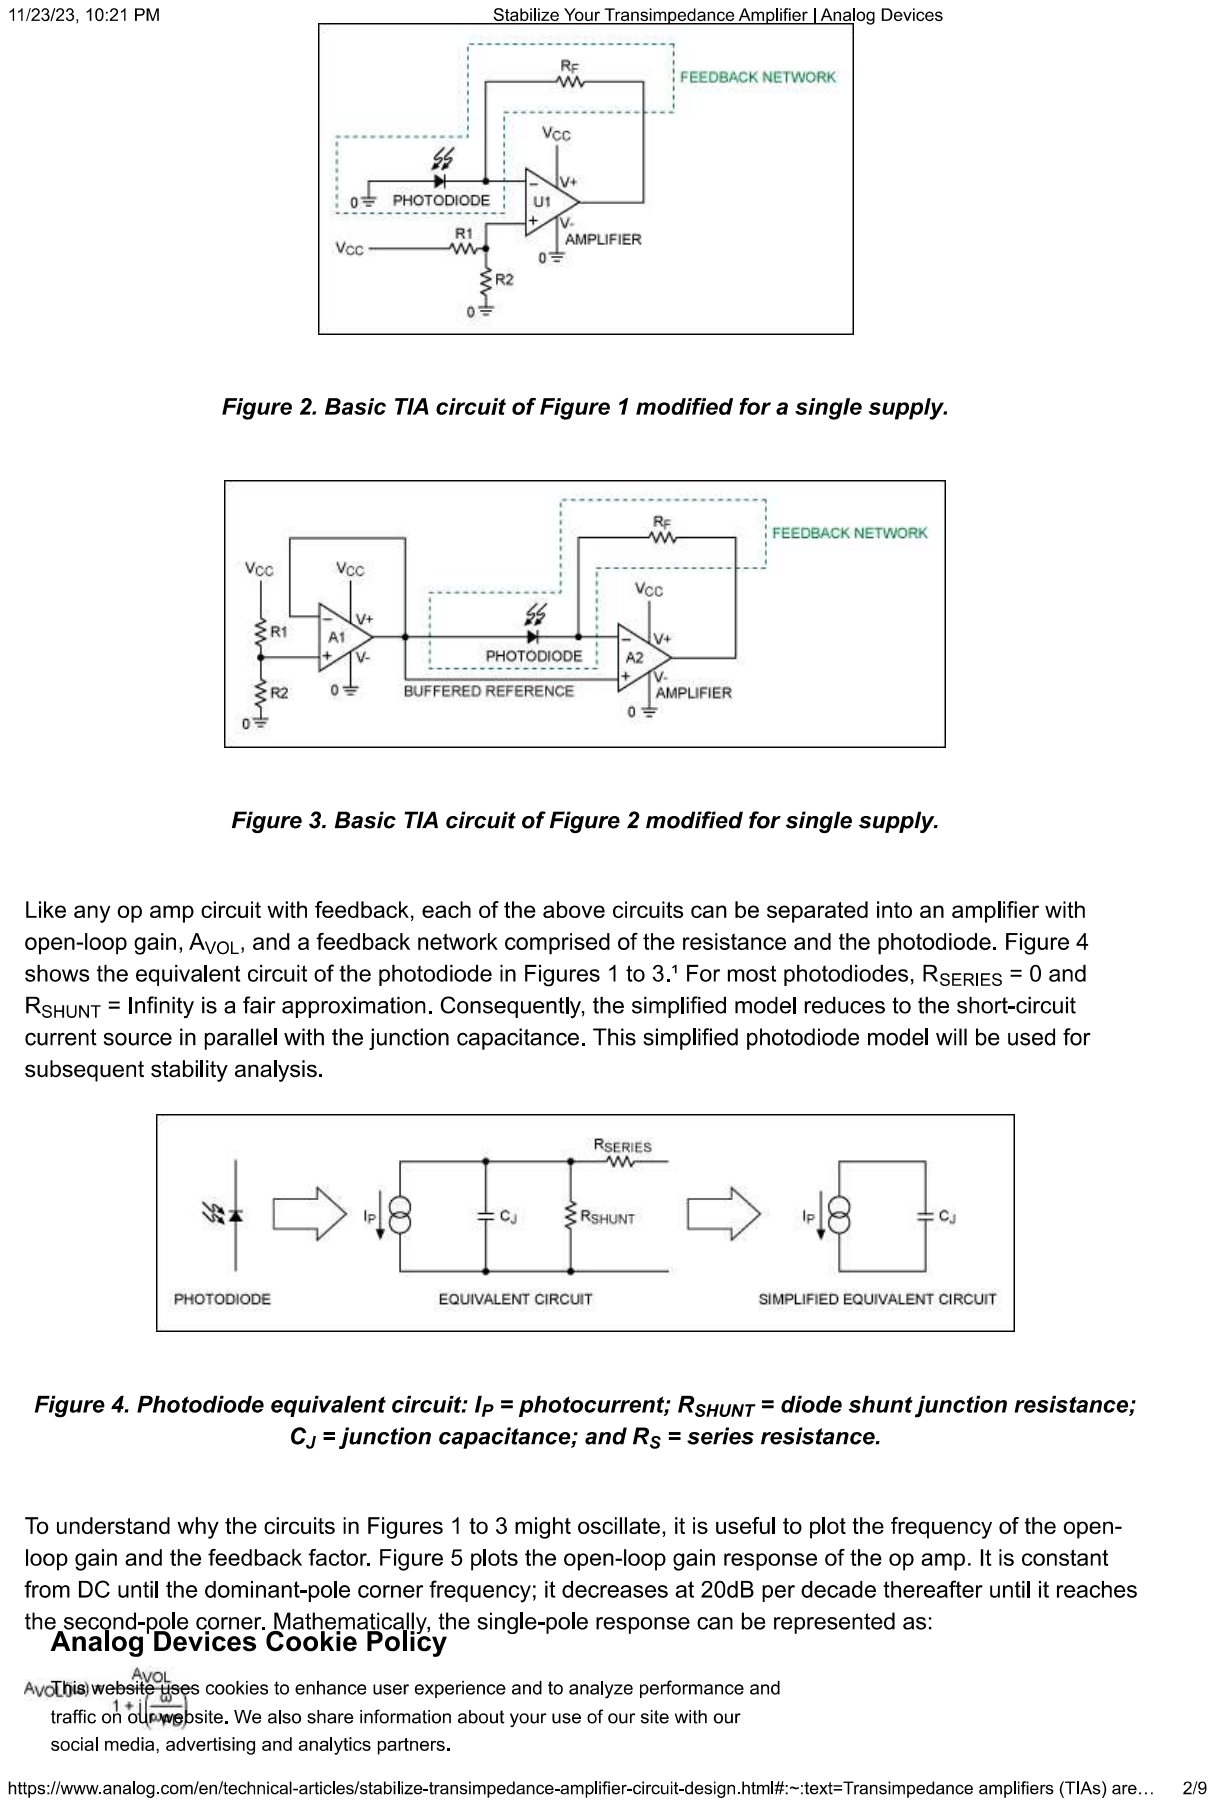
[picture p46: page 2]

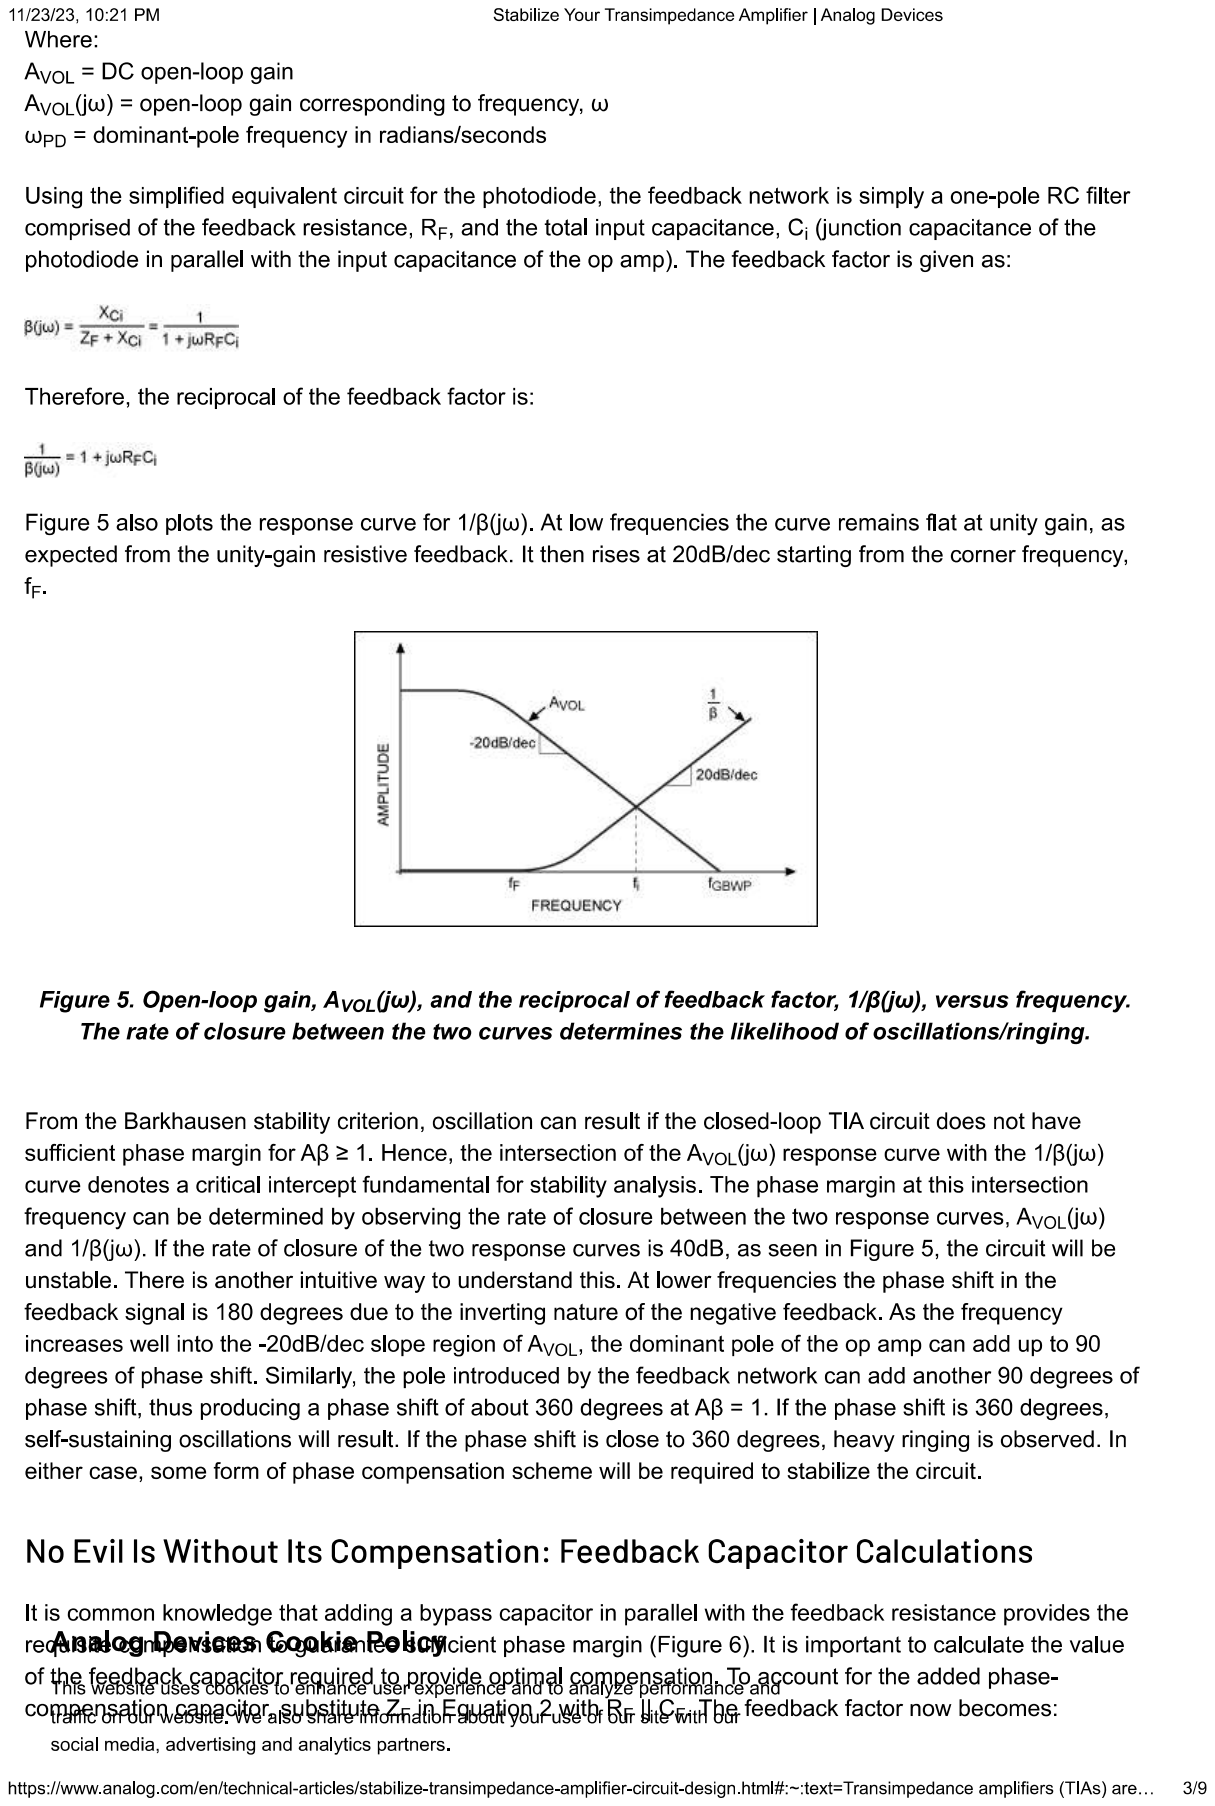
[picture p47: page 3]

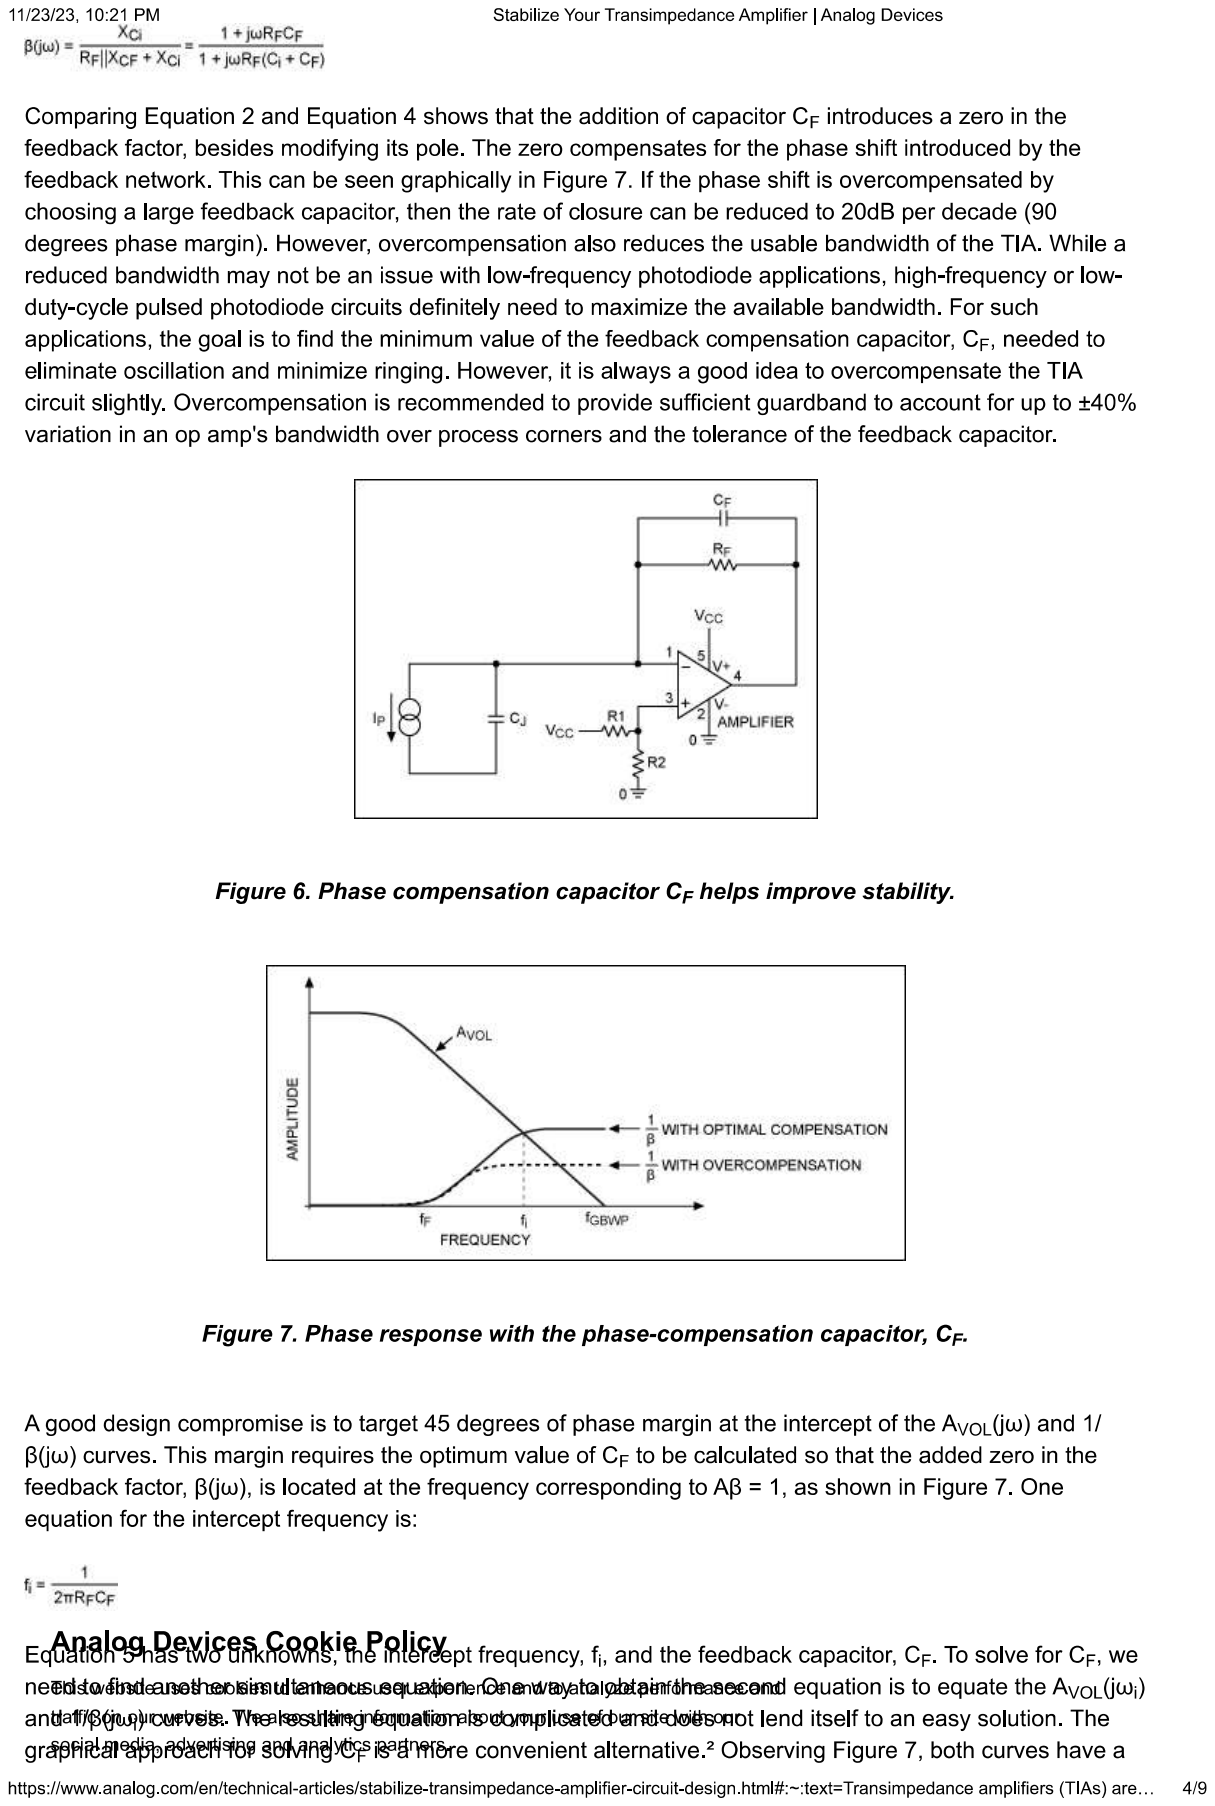
[picture p48: page 4]

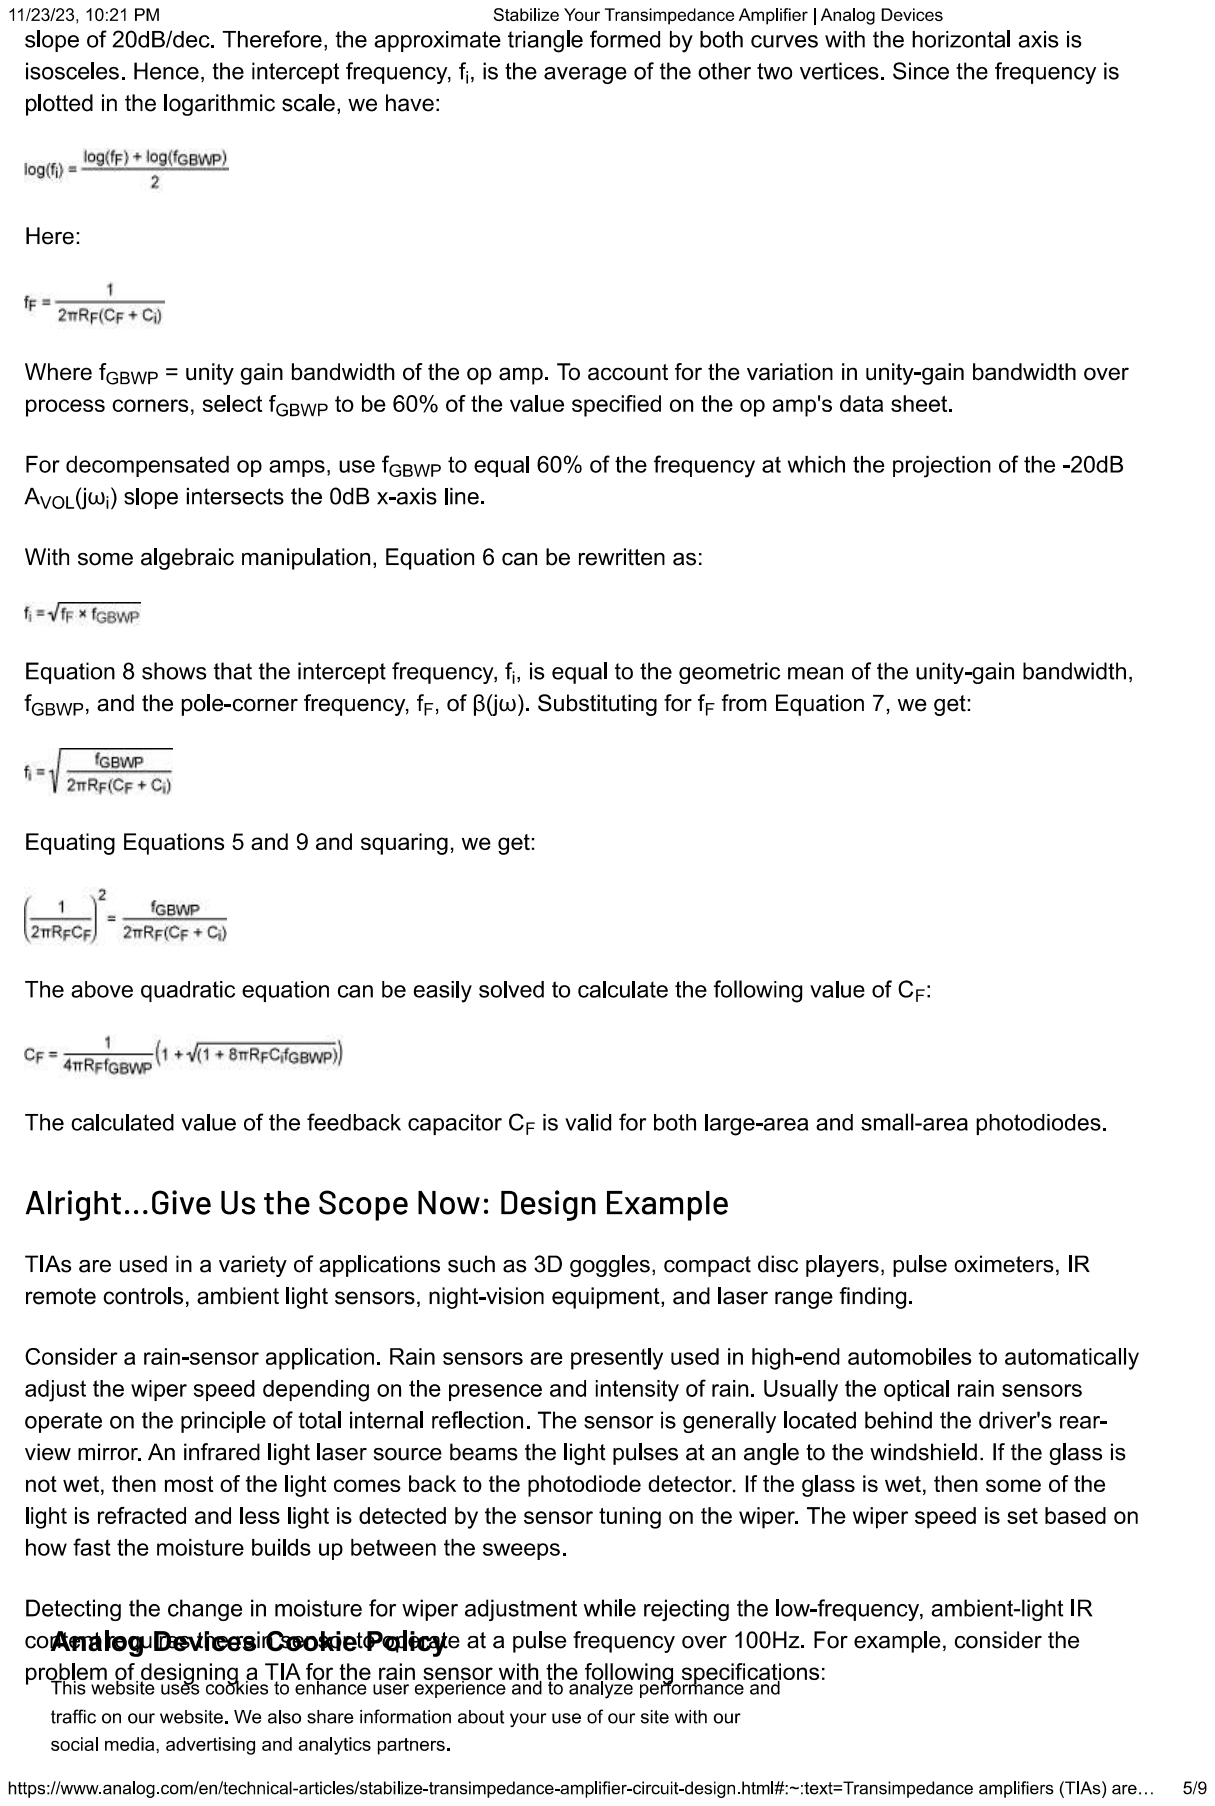
[picture p49: page 5]

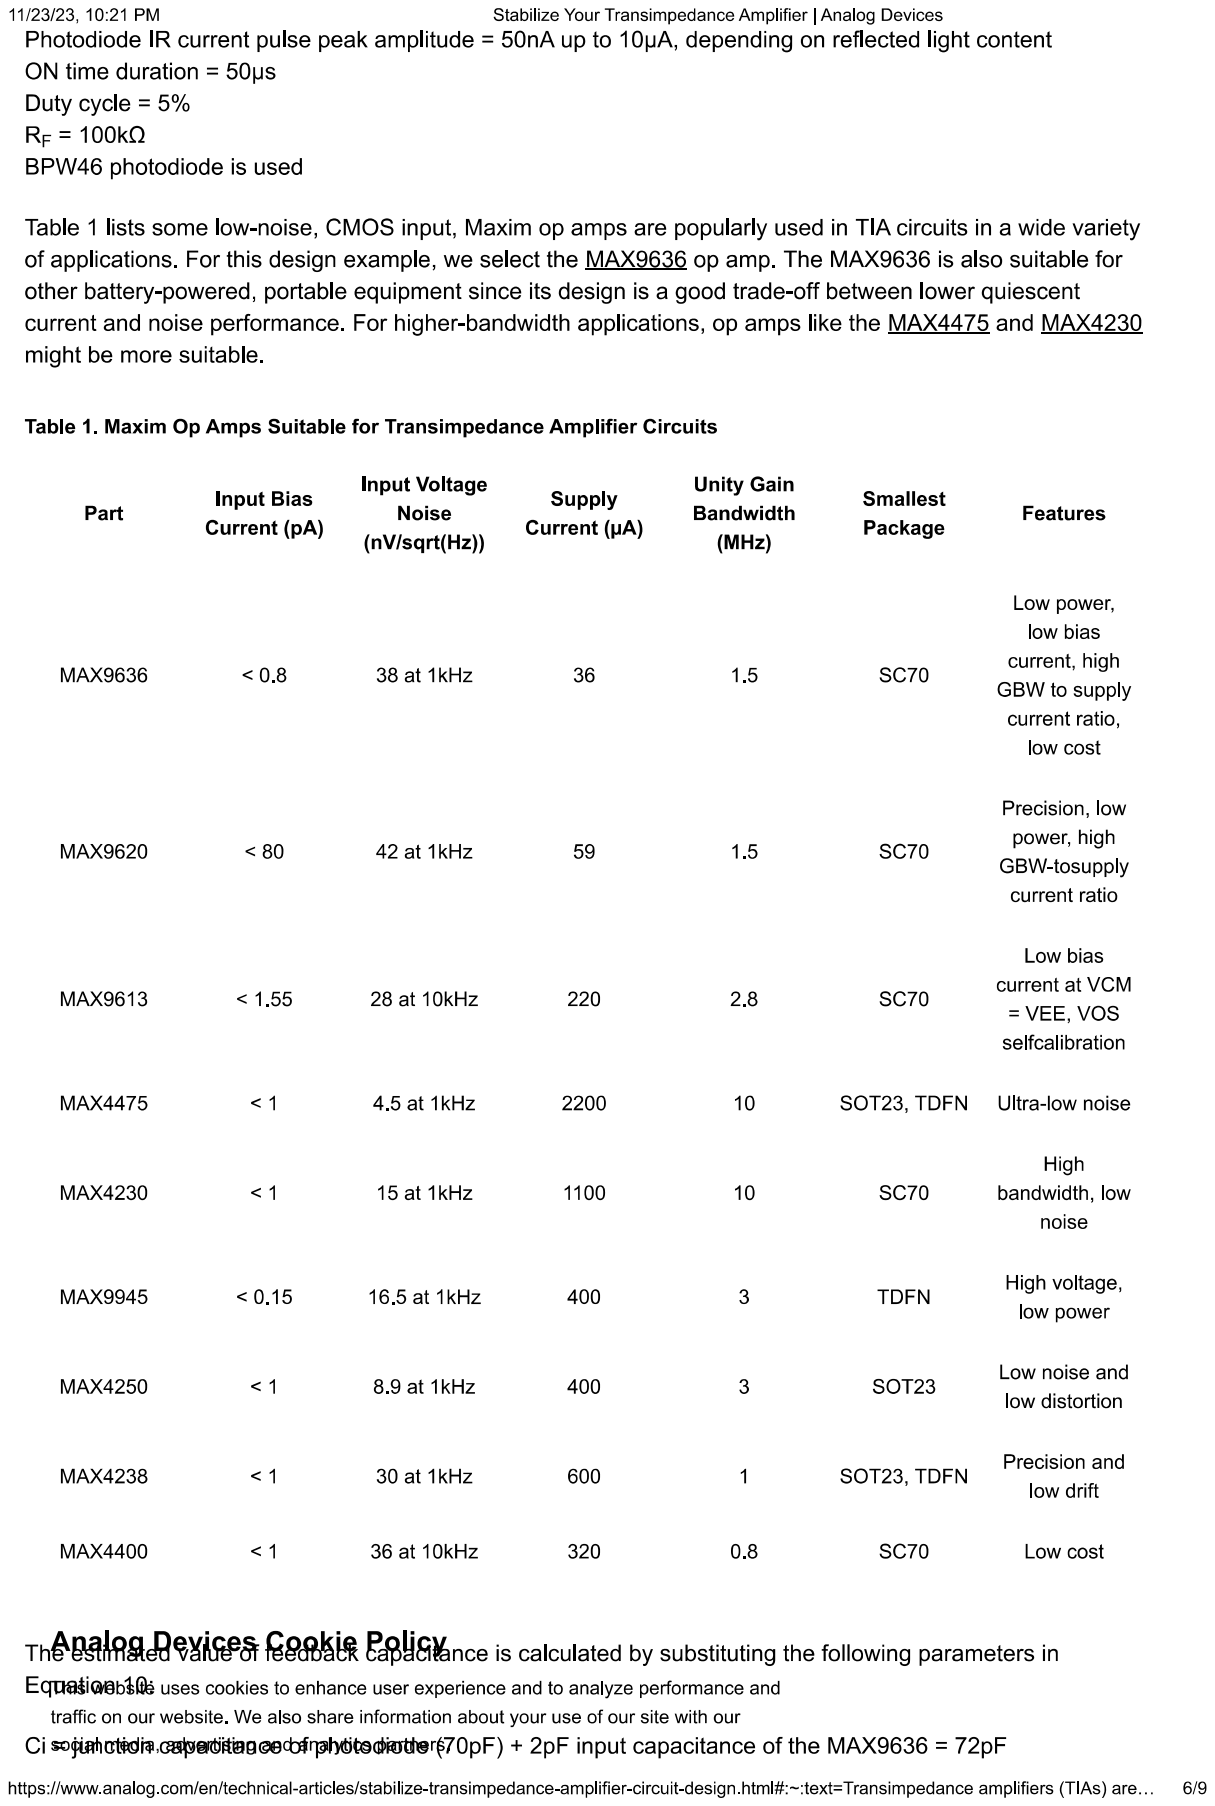
[picture p50: page 6]

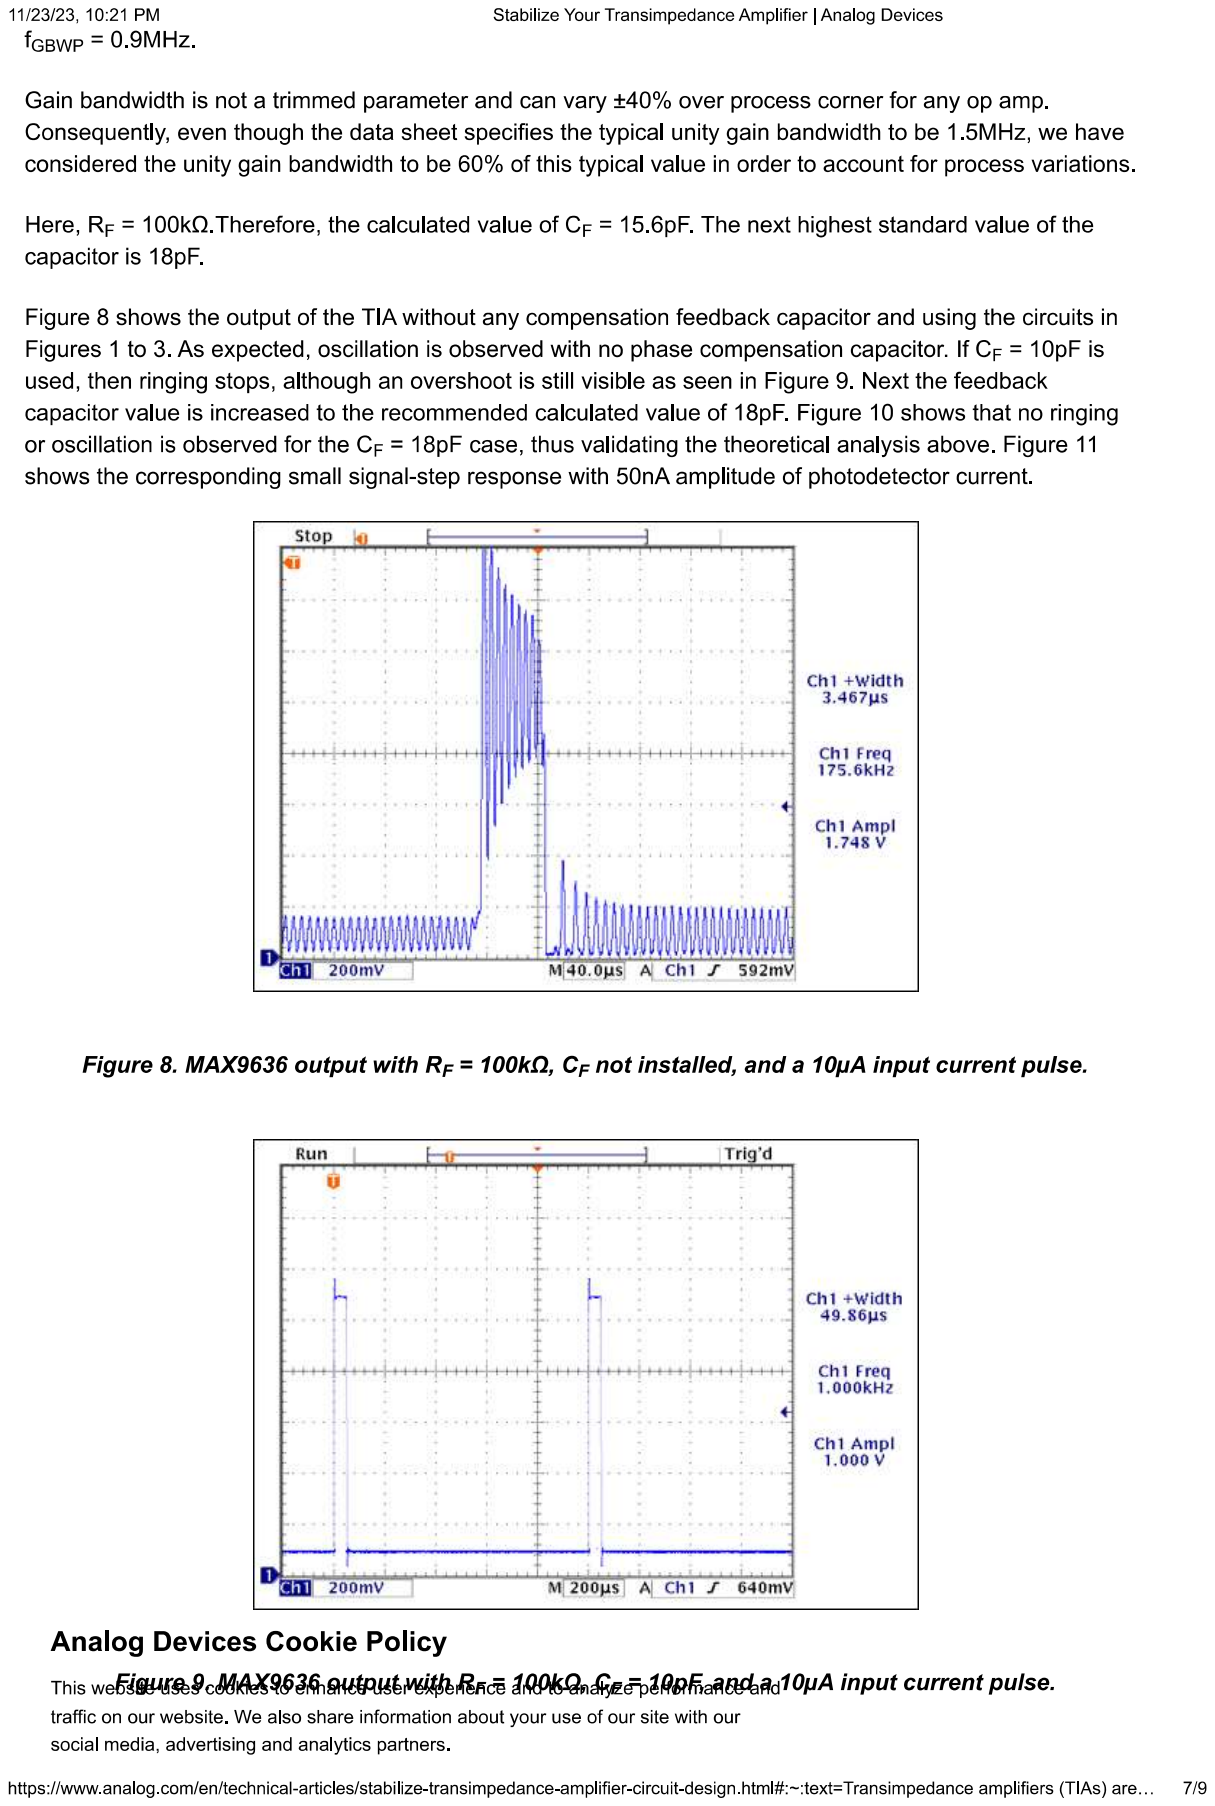
[picture p51: page 7]

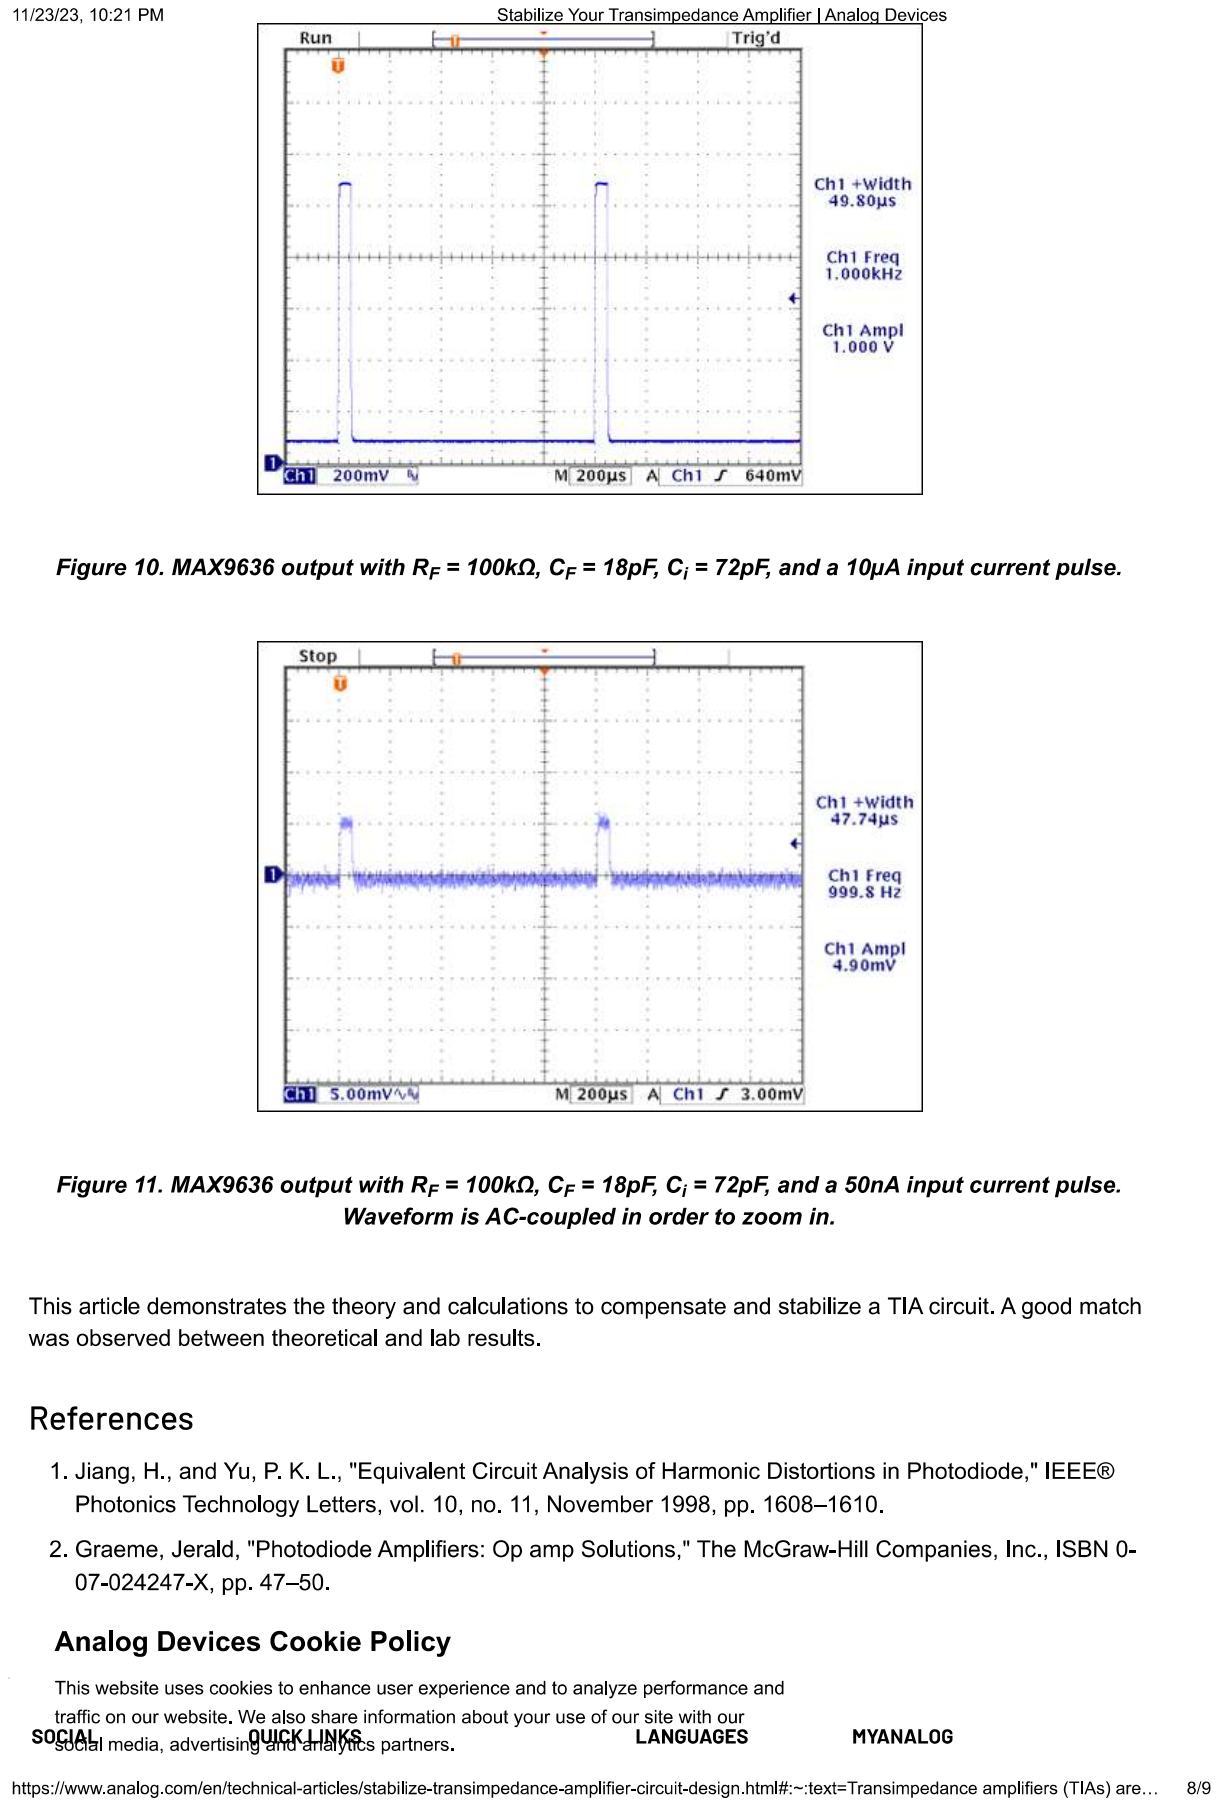
[picture p52: page 8]

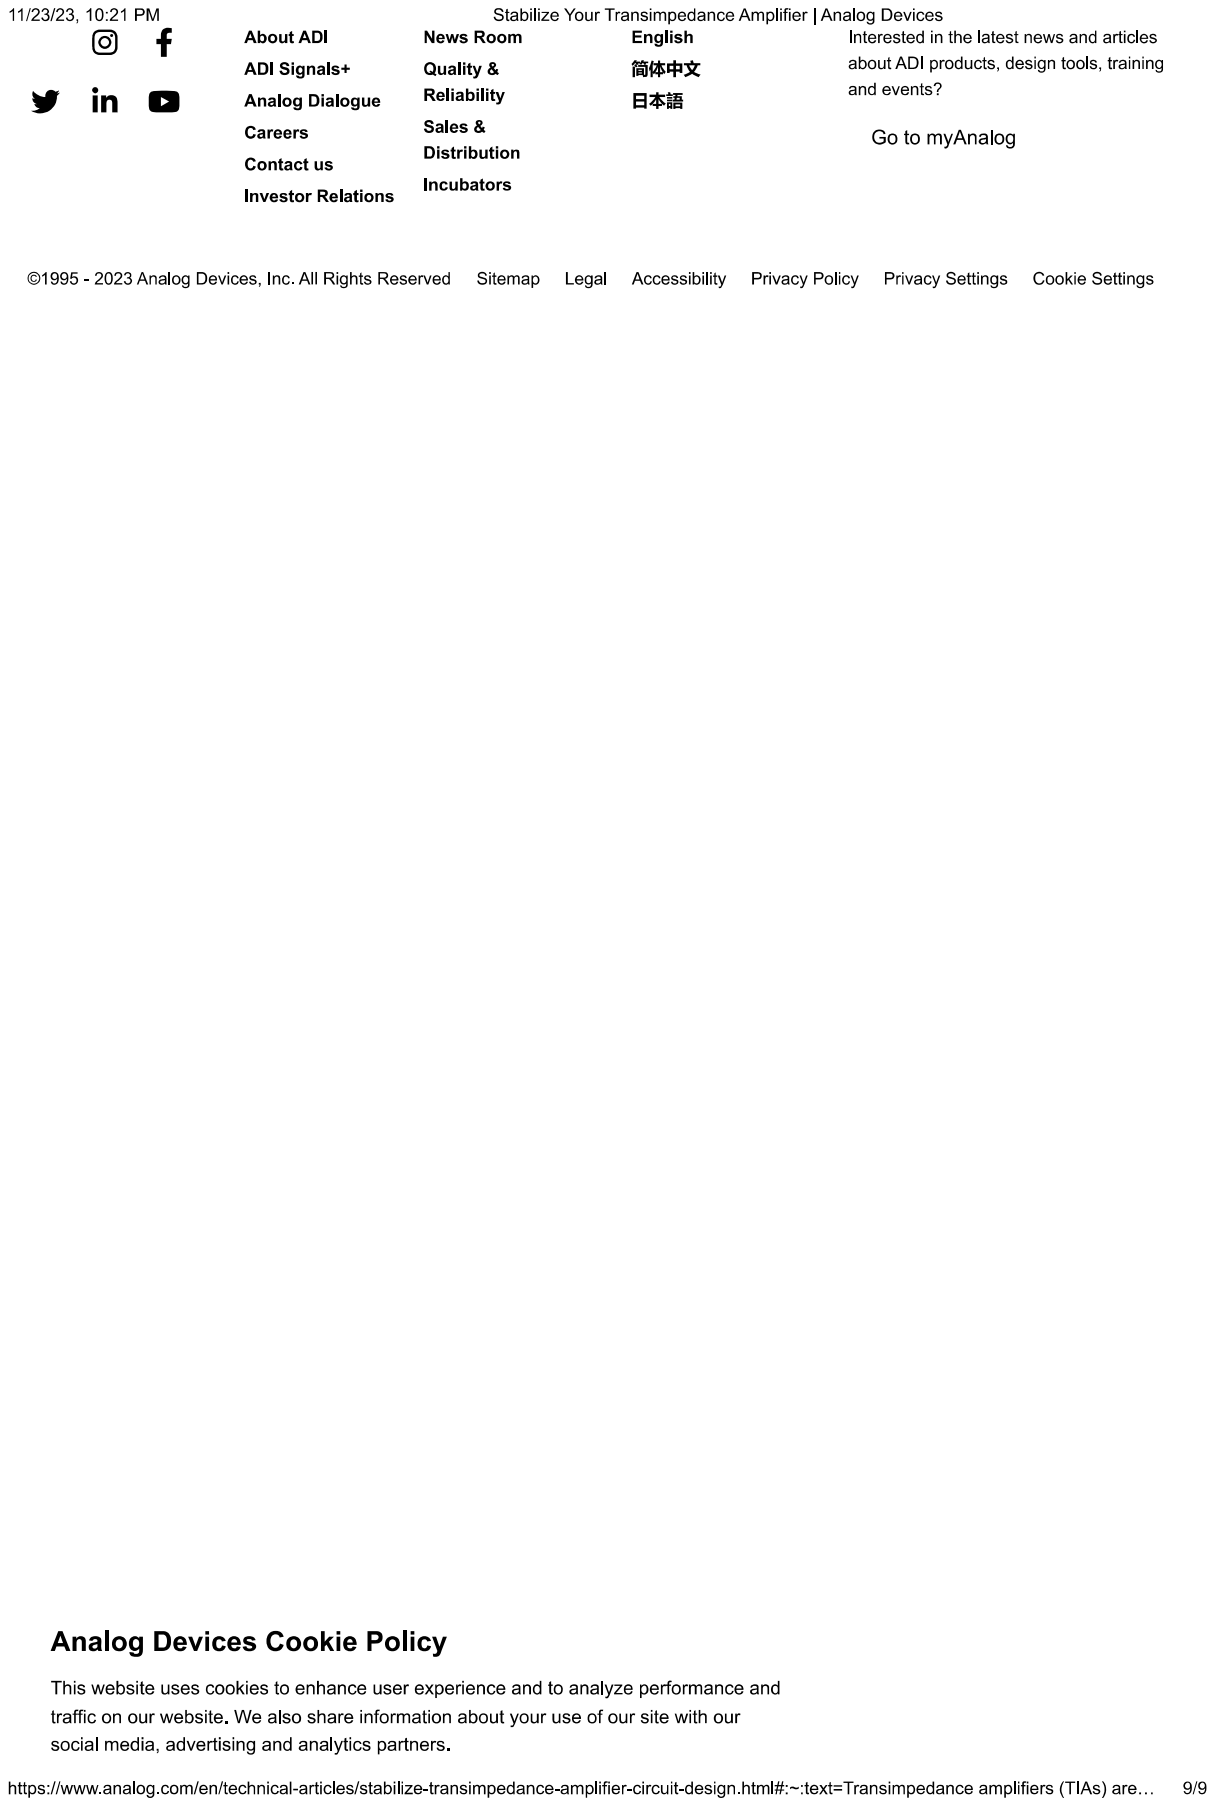
[picture p53: page 9]
