NUCEOTIDE/NUCLEOTIDE.github.io/Design Notes/Final Project SMD v1.pdf

No

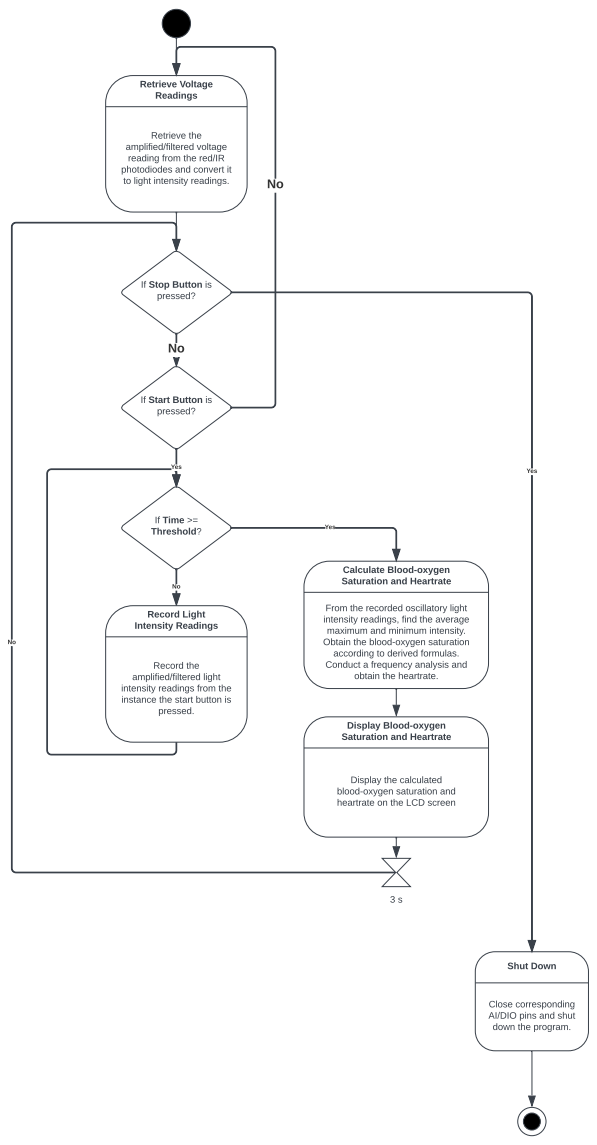
[picture p54: page 1]
If Time >= Threshold?; Yes; Shut Down; Record Light Intensity Readings; pressed.

Retrieve Voltage Readings

Retrieve the
amplified/filtered voltage
reading from the red/IR
photodiodes and convert it
to light intensity readings.

If Stop Button is
pressed?

If Start Button is

Calculate Blood-oxygen
Saturation and Heartrate

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

according to derived formulas. Conduct a frequency analysis and

Record the
amplified/filtered light
intensity readings from the
instance the start button is

obtain the heartrate.

Display Blood-oxygen

Display the calculated
blood-oxygen saturation and
heartrate on the LCD screen

Close corresponding
AI/DIO pins and shut
down the program.
