NUCEOTIDE/NUCLEOTIDE.github.io/(commit log)

2023-11-29 Submission Nov 28
    [Active Filter Circuit Characterization - Frequency Response Magnitude.xlsx, Engineering and User Specifications Team8_Yifei_Tianyang.xlsx, Engineering and User Specifications Team8_Yifei_Tianyang_v2.xlsx, Engineering and User Specifications Template.xlsx, Pulse Oximeter v1 v3 bottom.stl, Pulse Oximeter v1 v3 top.stl, Pulse Oximeter v1 v3.stl, Pulse Oximeter v1 v4.f3d]
2023-12-02 12.02 Update
    [Engineering and User Specifications Team8_Yifei_Tianyang_v21.xlsx]
2023-12-03 12.02_2 Canvas Submission Update
    Canvas Submission Ready.
    [Engineering and User Specifications Team8_Yifei_Tianyang_v21.xlsx]
